controlXic/onYX_Wind_Gesture_Midi_Controller/00_FIRMWARE/README.md

# onYX 
## MCU parts 

**Left, Mouth, Right, Router:** ESP32_WROOM_32D. ArduinoIDE  
**onyx_uChip_048:** PIC32MM0256GPM048-E_PT. MPLAB X IDE  
**Transducer_OLD:** Arduino Micro / Atmega32u4. ArduinoIDE
