controlXic/onYX_Wind_Gesture_Midi_Controller/docs/IMG-20261105-WA0009.jpg

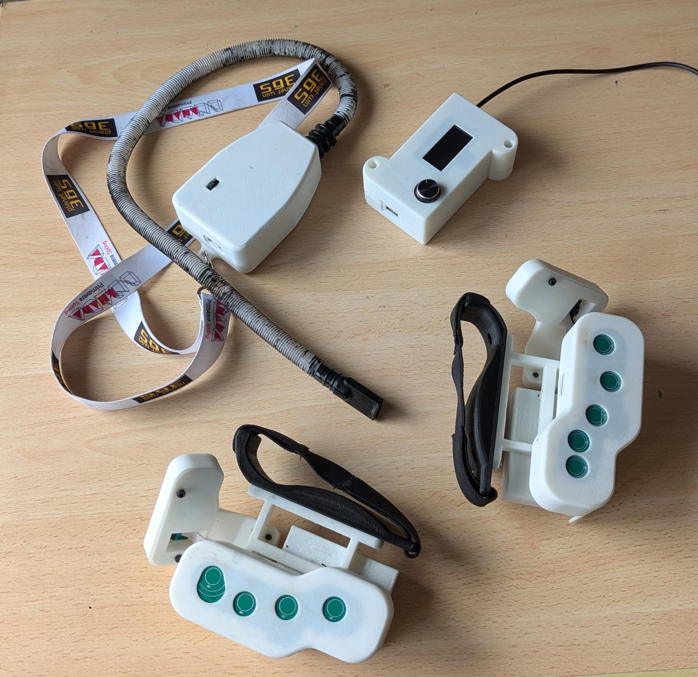
docs/IMG-20261105-WA0009.jpg
