controlXic/onYX_Wind_Gesture_Midi_Controller/Images/IMG-20210422-WA0029.jpg

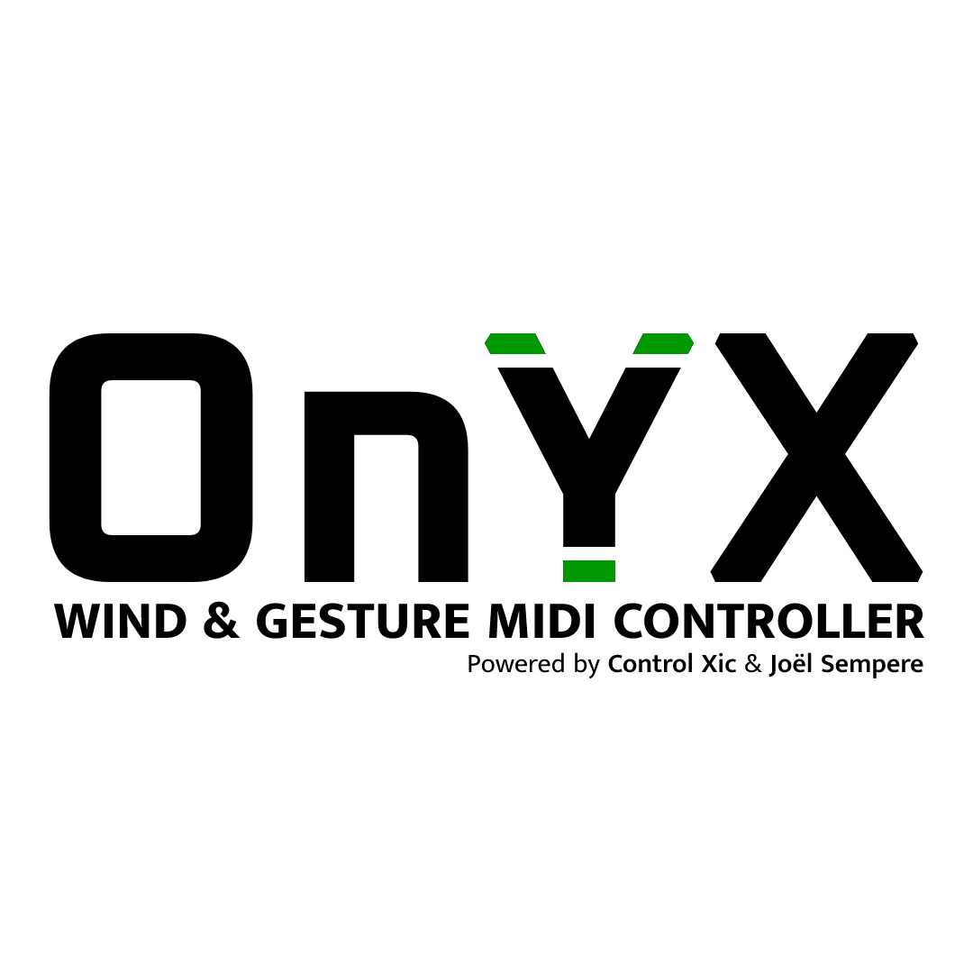
Images/IMG-20210422-WA0029.jpg
