controlXic/onYX_Wind_Gesture_Midi_Controller/01_PCB/onyxMandosV3_Dreta/onyxMandosV3_Dreta.step

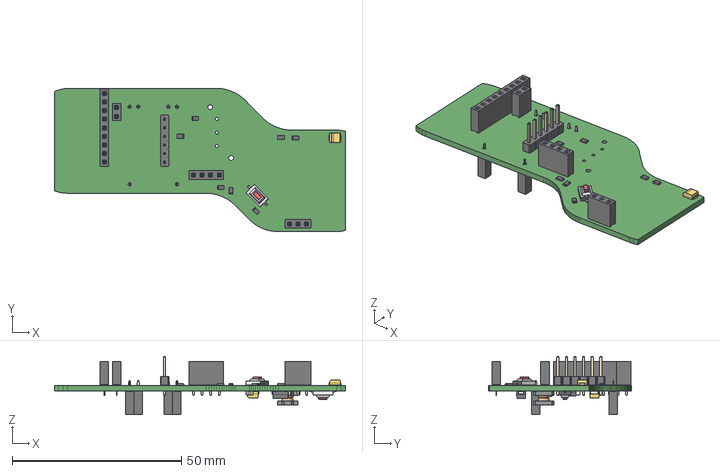
[picture p8: CAD file, 2026-11-02]
01_PCB/onyxMandosV3_Dreta/onyxMandosV3_Dreta.step
86.0 x 42.3 x 17.2 mm
