controlXic/onYX_Wind_Gesture_Midi_Controller/02_CAD/01_STL/boca/baseCase.stl

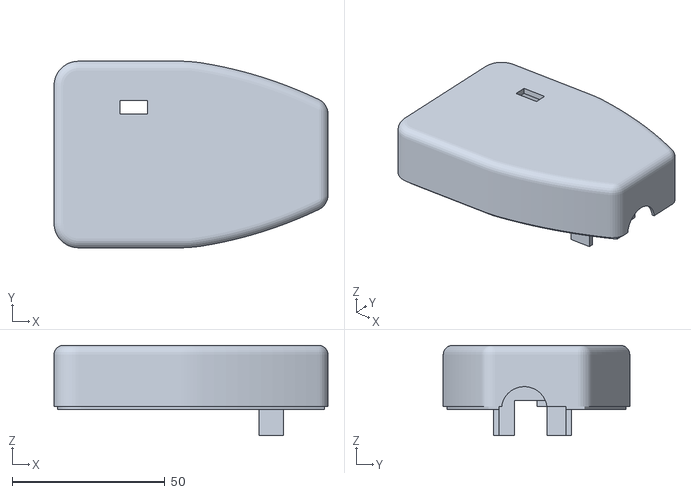
[picture p9: CAD file, 2026-11-02]
02_CAD/01_STL/boca/baseCase.stl
89.6 x 61.0 x 29.5
