controlXic/onYX_Wind_Gesture_Midi_Controller/02_CAD/01_STL/Dreta/basePolze.stl

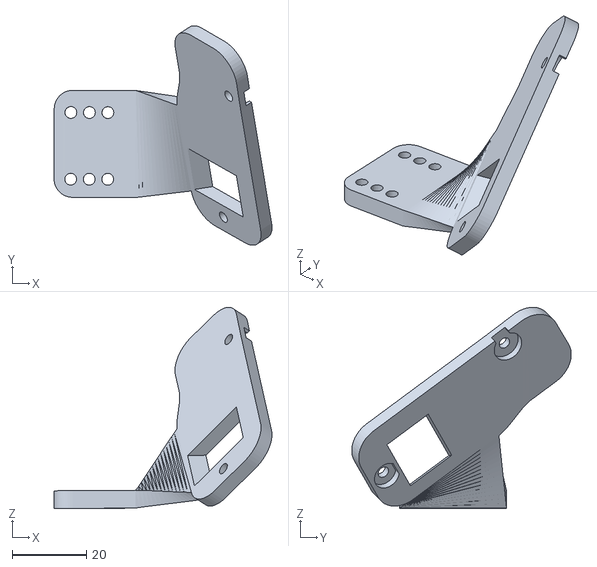
[picture p10: CAD file, 2026-11-02]
02_CAD/01_STL/Dreta/basePolze.stl
58.9 x 59.3 x 54.4
