controlXic/onYX_Wind_Gesture_Midi_Controller/02_CAD/01_STL/Esquerra/tapaPolze.stl

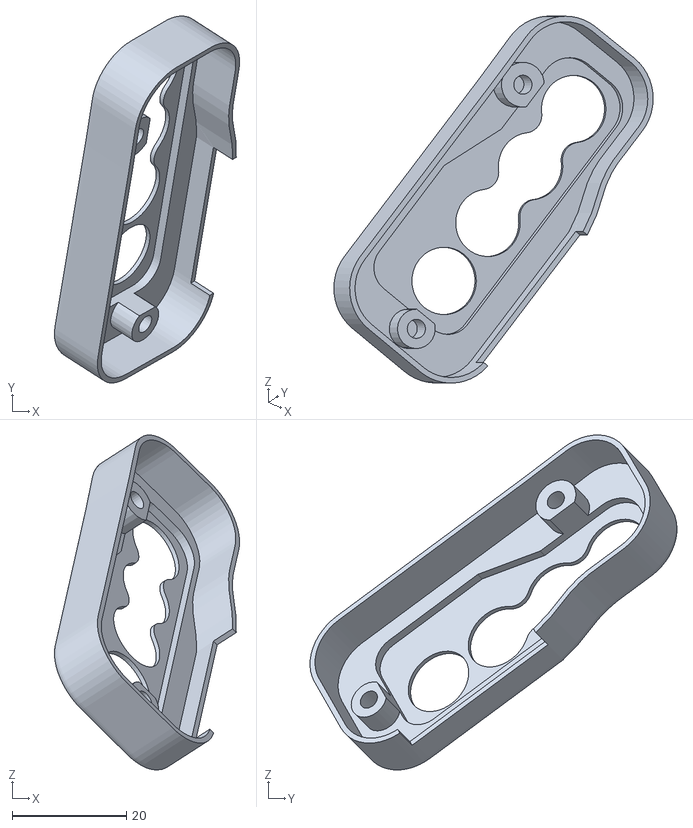
[picture p11: CAD file, 2026-11-02]
02_CAD/01_STL/Esquerra/tapaPolze.stl
32.4 x 64.2 x 58.6
