controlXic/onYX_Wind_Gesture_Midi_Controller/02_CAD/01_STL/router/baseRouter.stl

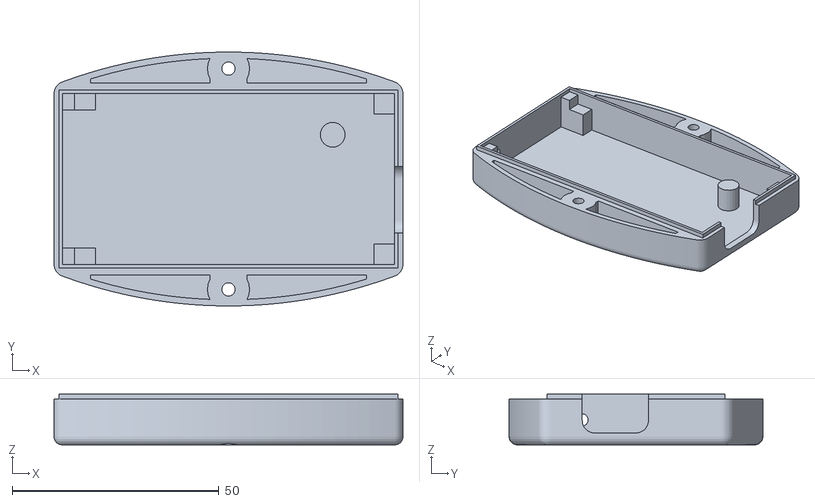
[picture p12: CAD file, 2026-11-02]
02_CAD/01_STL/router/baseRouter.stl
84.4 x 61.4 x 12.3
