controlXic/onYX_Wind_Gesture_Midi_Controller/02_CAD/01_STL/boca/tapaCase.stl

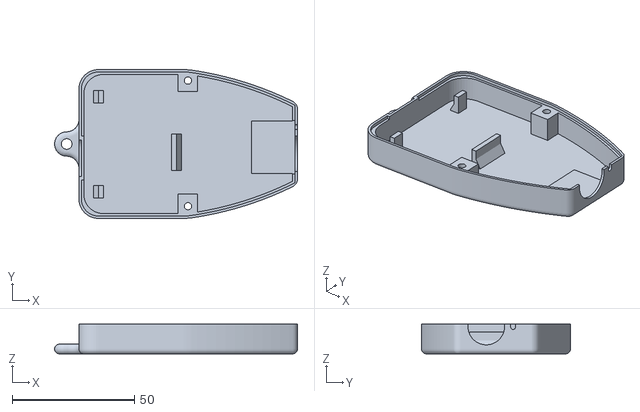
[picture p13: CAD file, 2026-11-02]
02_CAD/01_STL/boca/tapaCase.stl
99.6 x 61.0 x 12.2
