controlXic/onYX_Wind_Gesture_Midi_Controller/02_CAD/01_STL/Dreta/suportTouchPolze.stl

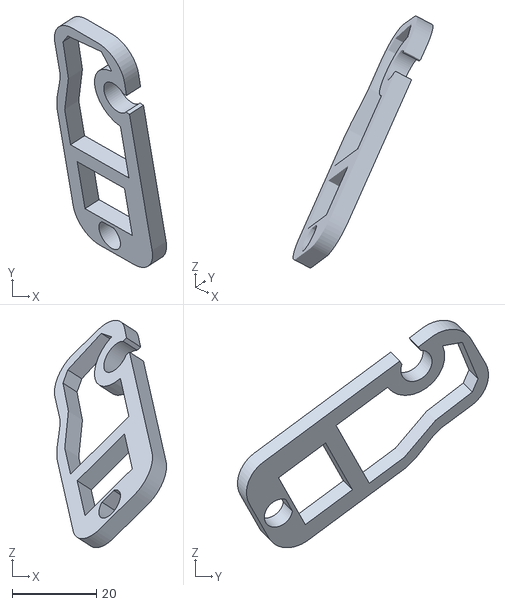
[picture p14: CAD file, 2026-11-02]
02_CAD/01_STL/Dreta/suportTouchPolze.stl
26.6 x 59.5 x 53.9
