controlXic/onYX_Wind_Gesture_Midi_Controller/02_CAD/01_STL/Esquerra/pom.stl

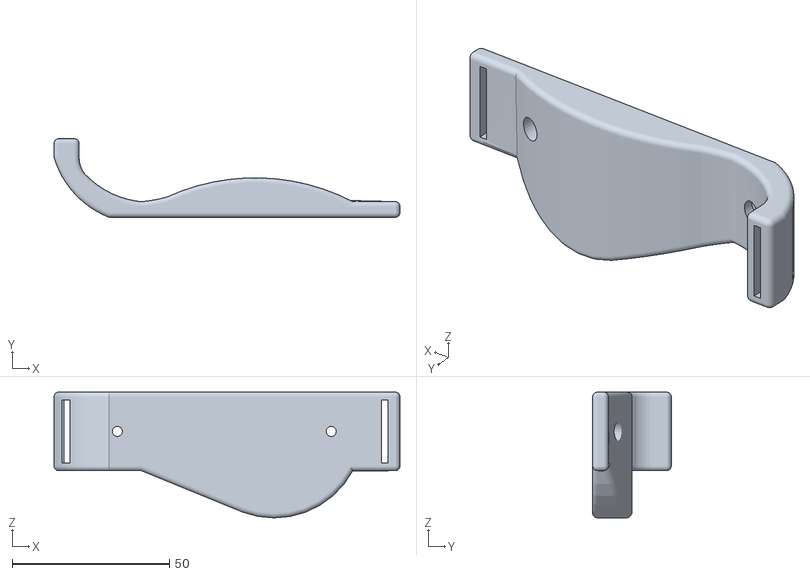
[picture p15: CAD file, 2026-11-02]
02_CAD/01_STL/Esquerra/pom.stl
110.0 x 25.0 x 40.0
