controlXic/onYX_Wind_Gesture_Midi_Controller/02_CAD/01_STL/router/tapaRouter.stl

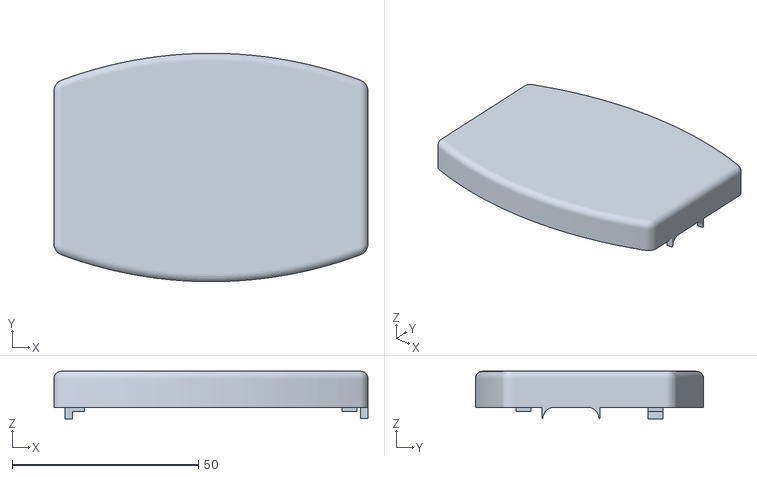
[picture p16: CAD file, 2026-11-02]
02_CAD/01_STL/router/tapaRouter.stl
84.4 x 61.4 x 12.8
