controlXic/onYX_Wind_Gesture_Midi_Controller/02_CAD/01_STL/boca/baseBatt.stl

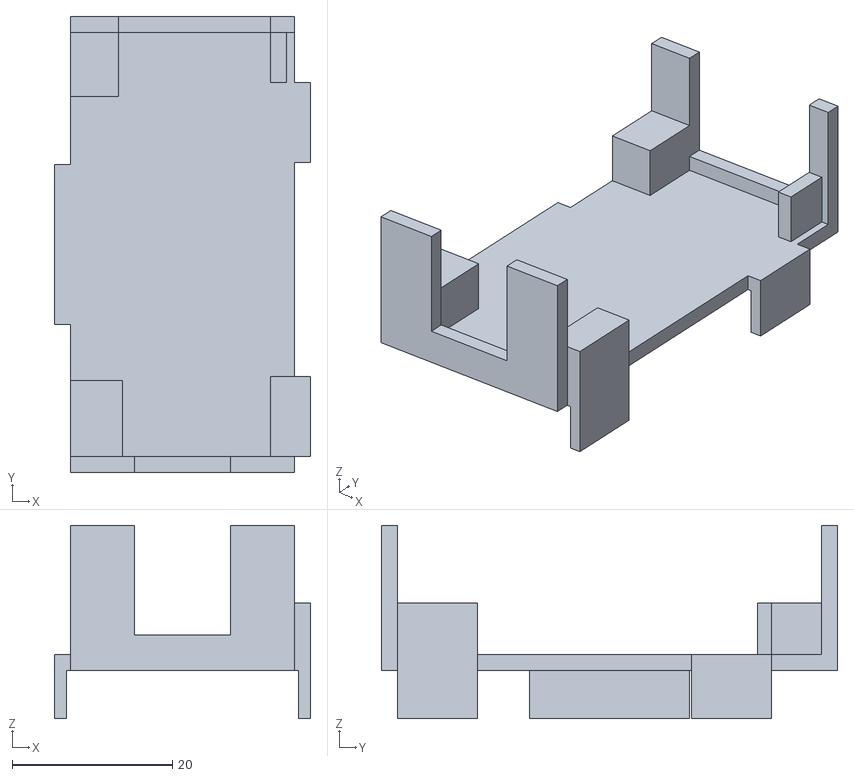
[picture p17: CAD file, 2026-11-02]
02_CAD/01_STL/boca/baseBatt.stl
32.0 x 57.0 x 24.2
