controlXic/onYX_Wind_Gesture_Midi_Controller/02_CAD/01_STL/Dreta/suportPcb.stl

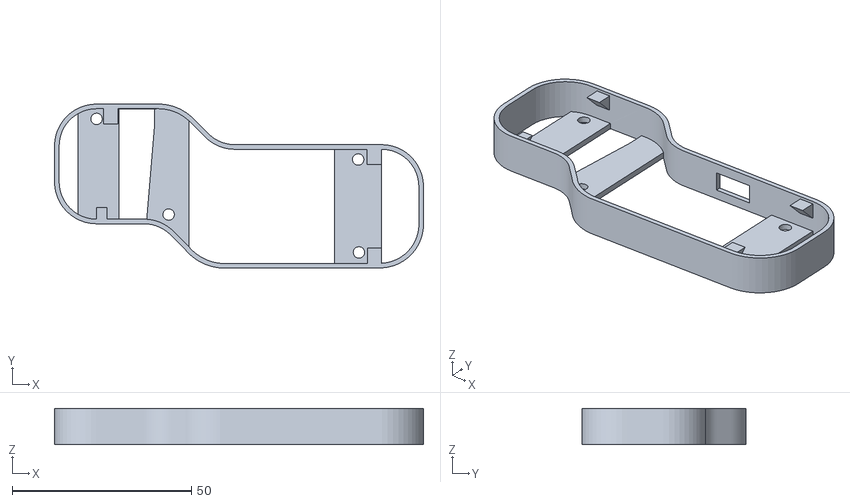
[picture p18: CAD file, 2026-11-02]
02_CAD/01_STL/Dreta/suportPcb.stl
102.9 x 45.7 x 10.1
