controlXic/onYX_Wind_Gesture_Midi_Controller/02_CAD/01_STL/Esquerra/tapaDits.stl

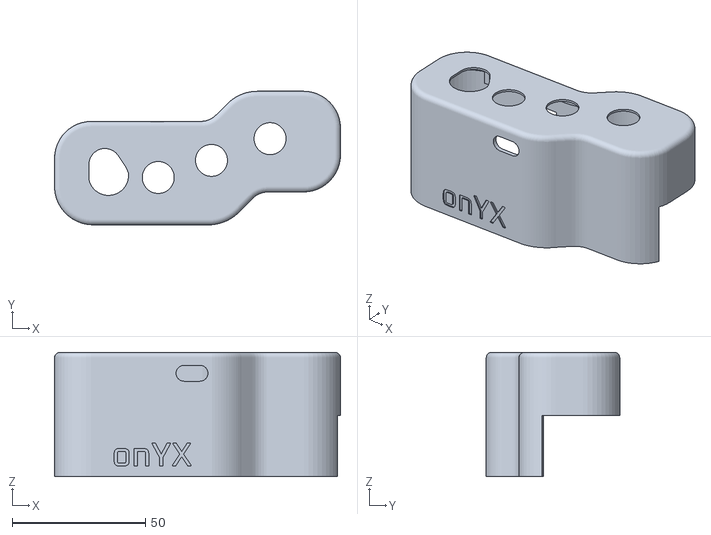
[picture p19: CAD file, 2026-11-02]
02_CAD/01_STL/Esquerra/tapaDits.stl
107.3 x 50.1 x 46.6
