controlXic/onYX_Wind_Gesture_Midi_Controller/02_CAD/01_STL/boca/T-vent.stl

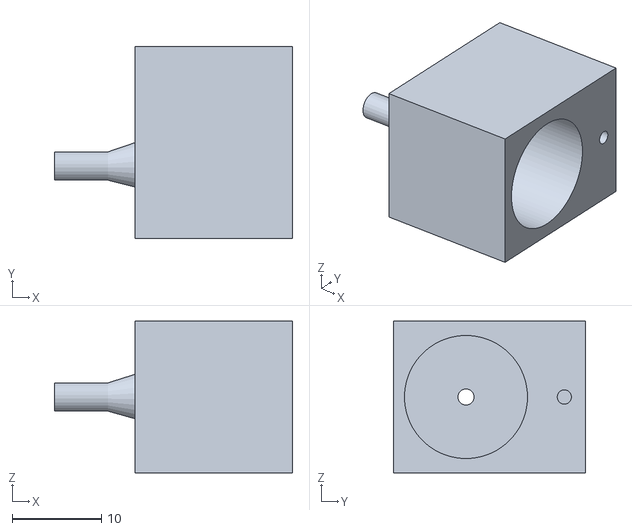
[picture p20: CAD file, 2026-11-02]
02_CAD/01_STL/boca/T-vent.stl
26.6 x 21.5 x 17.0
