controlXic/onYX_Wind_Gesture_Midi_Controller/02_CAD/01_STL/Dreta/baseUnio.stl

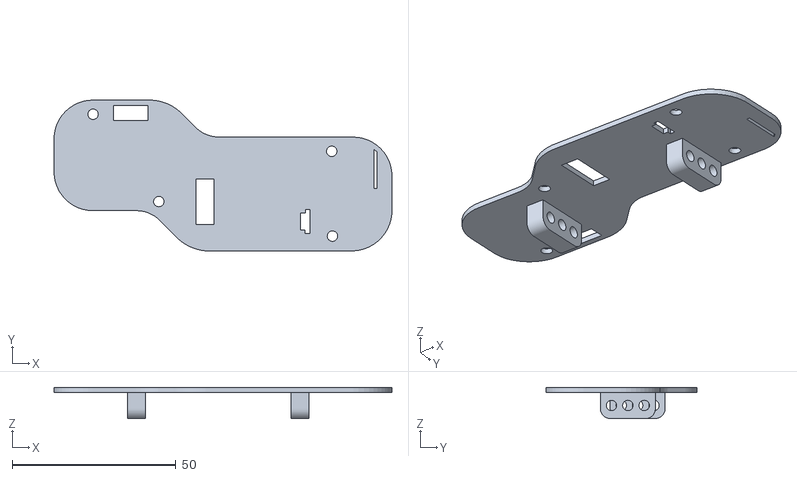
[picture p21: CAD file, 2026-11-02]
02_CAD/01_STL/Dreta/baseUnio.stl
103.3 x 46.1 x 9.50
