controlXic/onYX_Wind_Gesture_Midi_Controller/02_CAD/01_STL/Dreta/tapaBateria.stl

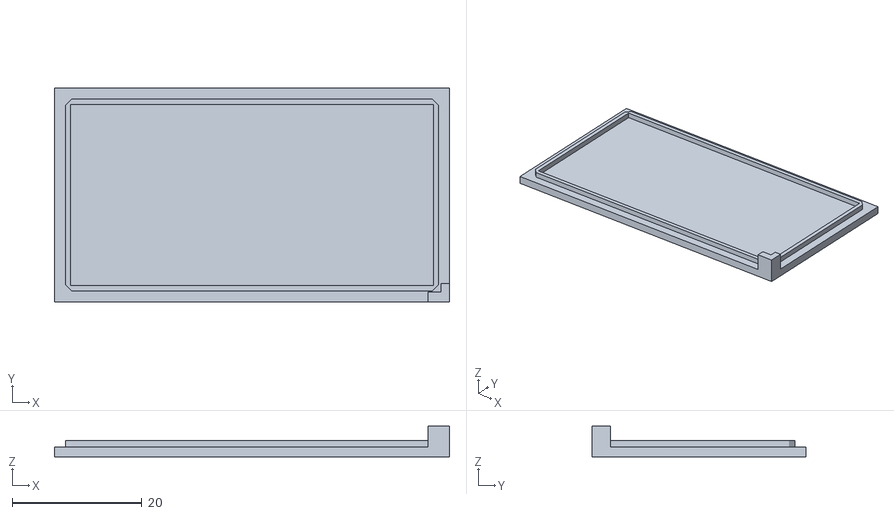
[picture p22: CAD file, 2026-11-02]
02_CAD/01_STL/Dreta/tapaBateria.stl
61.0 x 33.0 x 4.74
