controlXic/onYX_Wind_Gesture_Midi_Controller/02_CAD/01_STL/Dreta/unioPomDitsPolze.stl

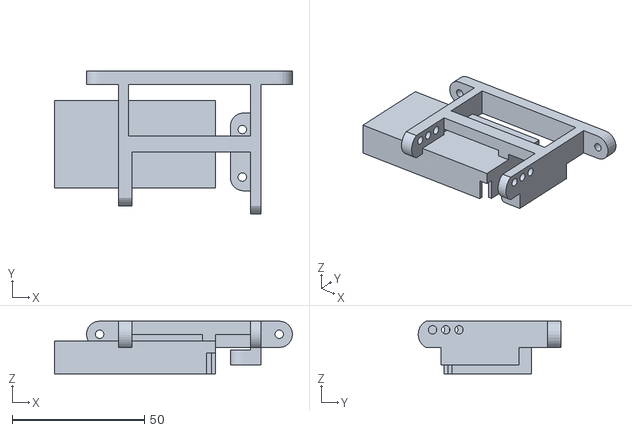
[picture p23: CAD file, 2026-11-02]
02_CAD/01_STL/Dreta/unioPomDitsPolze.stl
90.1 x 54.0 x 20.0
