controlXic/onYX_Wind_Gesture_Midi_Controller/02_CAD/01_STL/Esquerra/suportPcb2.stl

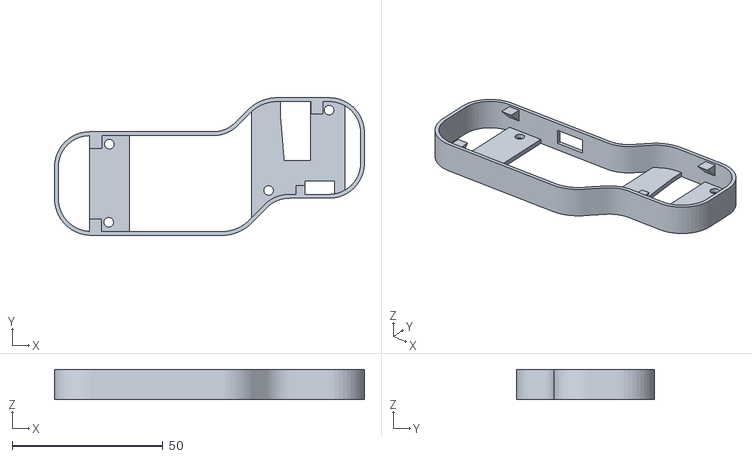
[picture p24: CAD file, 2026-11-02]
02_CAD/01_STL/Esquerra/suportPcb2.stl
102.9 x 45.7 x 10.1
