controlXic/onYX_Wind_Gesture_Midi_Controller/02_CAD/01_STL/Dreta/suportTouchDits.stl

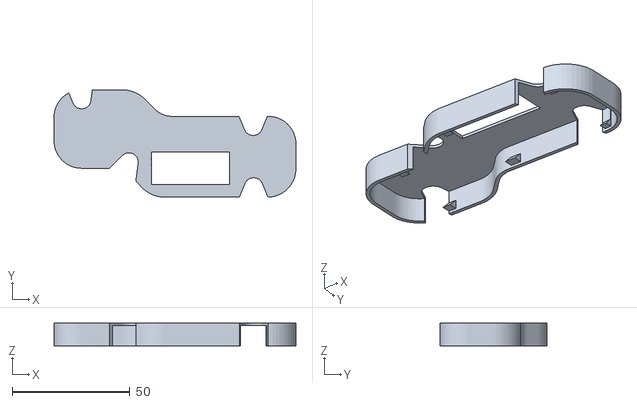
[picture p25: CAD file, 2026-11-02]
02_CAD/01_STL/Dreta/suportTouchDits.stl
102.9 x 45.7 x 9.61
