controlXic/onYX_Wind_Gesture_Midi_Controller/(list of files, cad)

Other CAD files:
02_CAD/01_STL/Esquerra/baseUnio.stl
02_CAD/01_STL/Esquerra/basePolze.stl
02_CAD/01_STL/Esquerra/tapaBateria.stl
02_CAD/01_STL/Dreta/tapaPolze.stl
02_CAD/01_STL/Esquerra/unioPomDitsPolze.stl
02_CAD/01_STL/Dreta/tapaDits.stl
02_CAD/01_STL/Esquerra/gruixMigPolze.stl
02_CAD/01_STL/Dreta/pom.stl
02_CAD/00_WORK/CASE_v4.skp
