controlXic/onYX_Wind_Gesture_Midi_Controller/01_PCB/onyxMandosTouchV3_Dreta/onyxMandosTouchV3_Dreta.kicad_pcb

## KiCad design 01_PCB/onyxMandosTouchV3_Dreta/onyxMandosTouchV3_Dreta.kicad_pcb (2026-11-02)

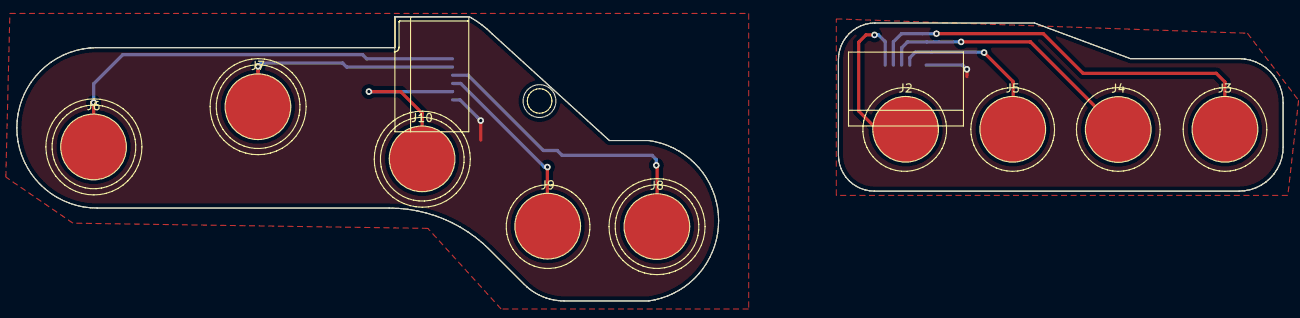
[picture p27: board onyxMandosTouchV3_Dreta.kicad_pcb from above]

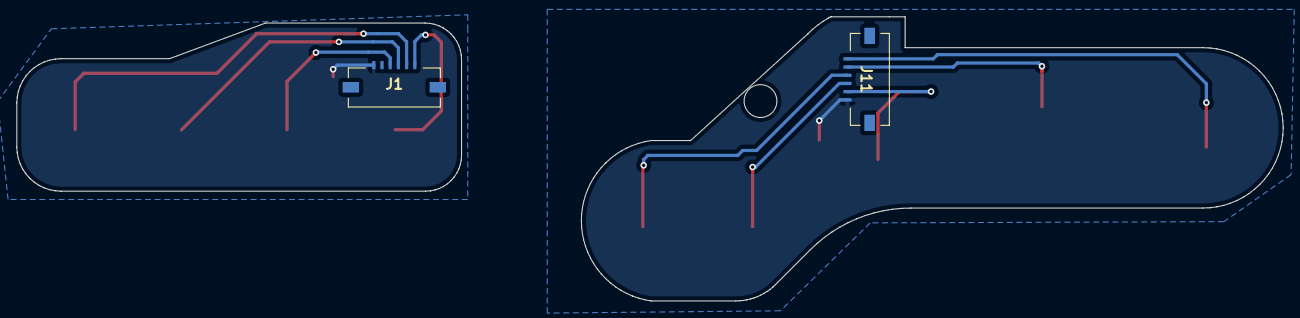
[picture p28: board onyxMandosTouchV3_Dreta.kicad_pcb from below]

Board: 2 copper layers, 154.3 x 34.6 mm, 11 parts (2 on the bottom side), 9 nets.

Parts:
J1, J11: 200529-0060; 2005290060
J2, J3, J4, J5, J6, J7, J8, J9, J10: Conn_01x01_Male; onYX_touch

Connections:
/K0_R: J1.6, J2.1
/K1_R: J1.5, J3.1
/K2_R: J1.4, J4.1
/K3_R: J1.3, J5.1
/K4_R: J6.1, J11.6
/K5_R: J7.1, J11.5
/K6_R: J8.1, J11.4
/K7_R: J9.1, J11.3
/K8_R: J10.1, J11.2
