controlXic/onYX_Wind_Gesture_Midi_Controller/01_PCB/onyxMandosV3_Dreta/onyxMandosV3_Dreta.kicad_pcb

## KiCad design 01_PCB/onyxMandosV3_Dreta/onyxMandosV3_Dreta.kicad_pcb (2026-11-02)

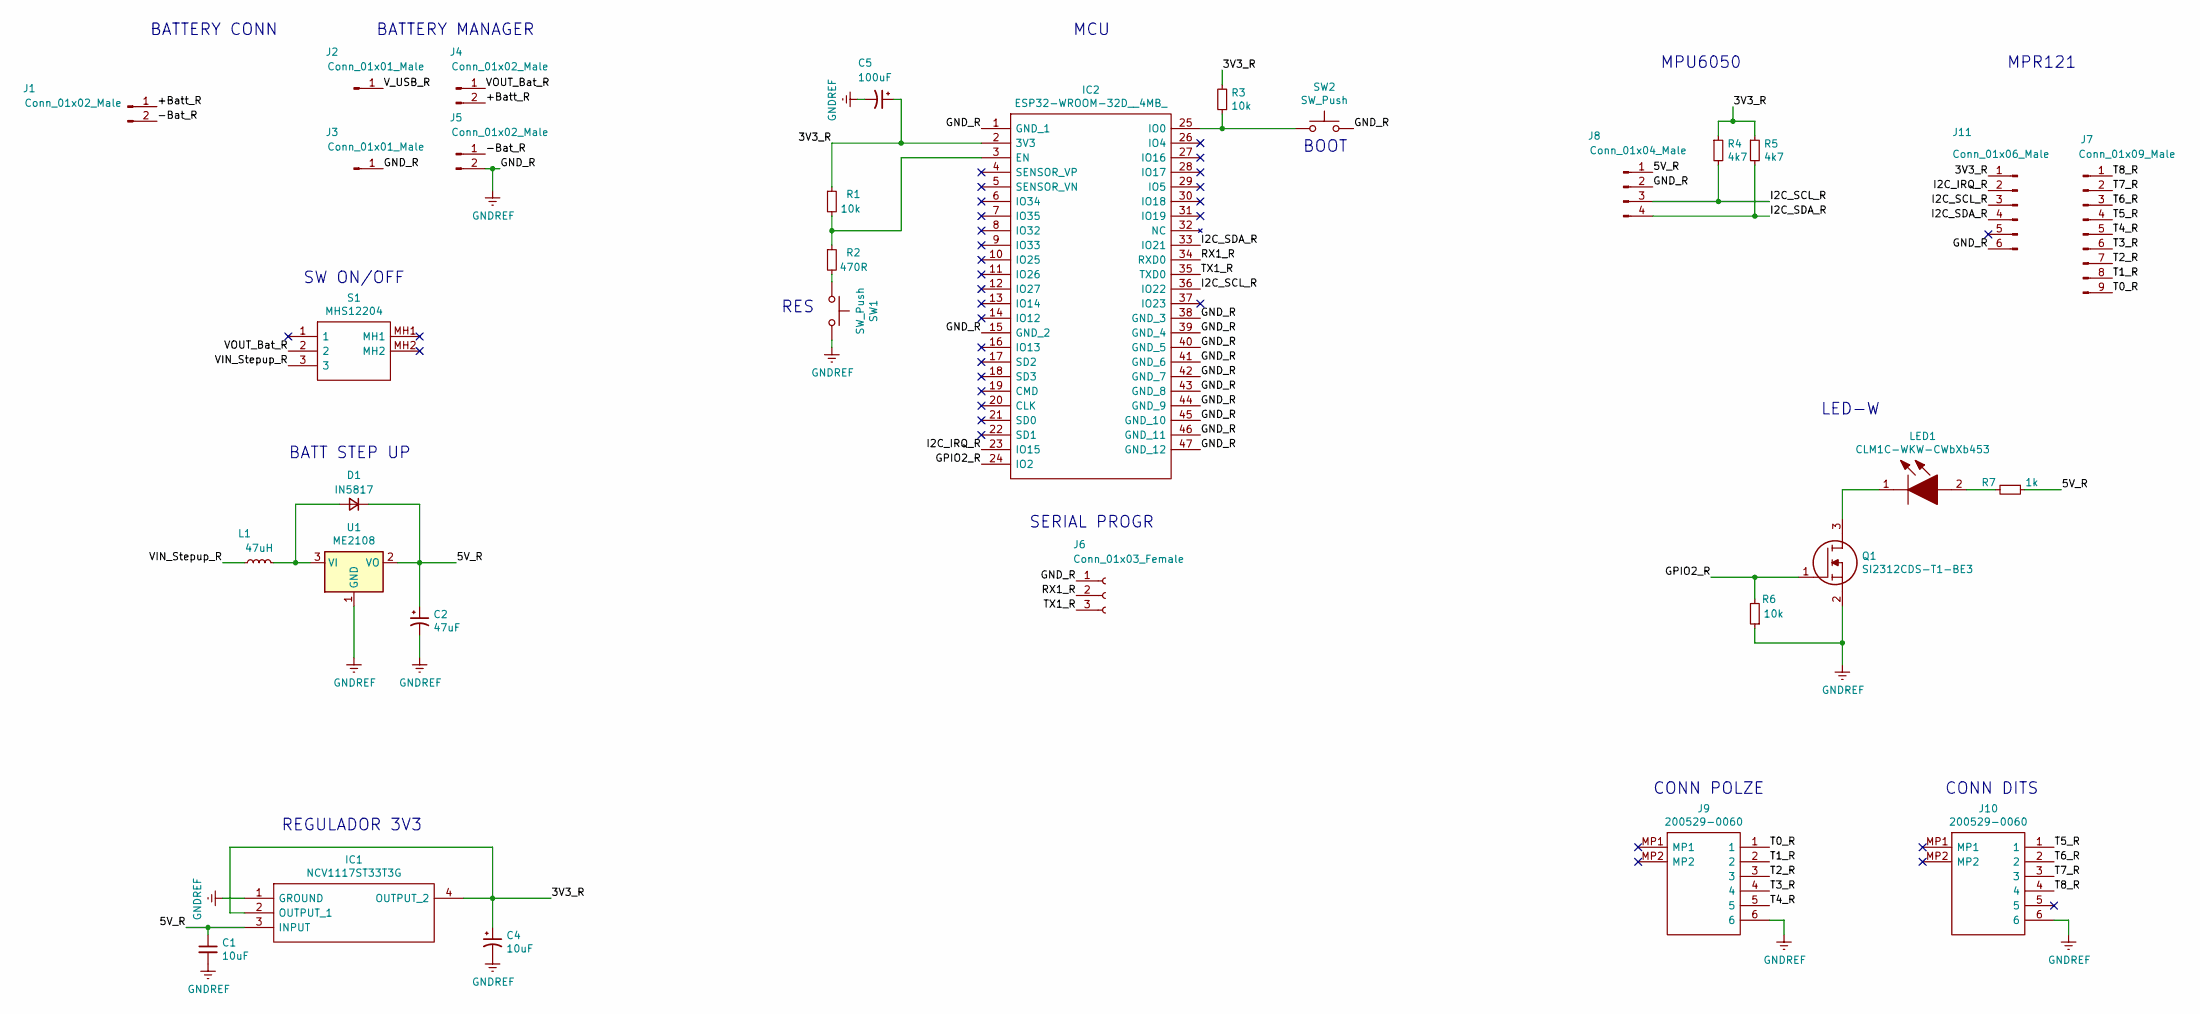
[picture p29: schematic onyxMandosV3_Dreta.kicad_sch]

Parts:
C1: 10uF; C_0805_2012Metric_Pad1.15x1.40mm_HandSolder
C2: 47uF; CP_EIA-3528-21_Kemet-B_Pad1.50x2.35mm_HandSolder
C4: 10uF; CP_EIA-3528-21_Kemet-B_Pad1.50x2.35mm_HandSolder
C5: 100uF; CP_EIA-3528-15_AVX-H
D1: IN5817; D_SMA
IC1: NCV1117ST33T3G; SOT230P700X180-4N; Manufacturer_Part_Number NCV1117ST33T3G; Mouser Part Number 863-NCV1117ST33T3G
IC2: ESP32-WROOM-32D__4MB_; ESP32WROOM32D4MB; Manufacturer_Part_Number ESP32-WROOM-32D (4MB); Mouser Part Number 356-ESP32WROOM-32D
J1, J4, J5: Conn_01x02_Male; PinSocket_1x02_P2.54mm_Vertical
J2, J3: Conn_01x01_Male; PinSocket_1x01_P2.54mm_Vertical
J6: Conn_01x03_Female; PinSocket_1x03_P2.54mm_Vertical
J7: Conn_01x09_Male; PinSocket_1x09_P2.54mm_Vertical
J8: Conn_01x04_Male; PinSocket_1x04_P2.54mm_Vertical
J9, J10: 200529-0060; 2005290060; Manufacturer_Part_Number 200529-0060; Mouser Part Number 538-200529-0060
J11: Conn_01x06_Male; PinHeader_1x06_P2.54mm_Vertical
L1: 47uH; L_Bourns_SRN6045TA
LED1: CLM1C-WKW-CWbXb453; LEDM3528X205N; Manufacturer_Part_Number CLM1C-WKW-CWbXb453; Mouser Part Number 941-CLM1CWKWCWBXB453
Q1: SI2312CDS-T1-BE3; SOT95P237X112-3N; Manufacturer_Part_Number SI2312CDS-T1-BE3; Mouser Part Number 78-SI2312CDS-T1-BE3
R1, R3, R6: 10k; R_0805_2012Metric_Pad1.15x1.40mm_HandSolder
R2: 470R; R_0805_2012Metric_Pad1.15x1.40mm_HandSolder
R4, R5: 4k7; R_0805_2012Metric_Pad1.15x1.40mm_HandSolder
R7: 1k; R_0805_2012Metric_Pad1.15x1.40mm_HandSolder
S1: MHS12204; Manufacturer_Part_Number MHS12204; Mouser Part Number 506-MHS12204
SW1, SW2: SW_Push; SW_SPST_CK_RS282G05A3
U1: ME2108; SOT-89-3

Connections:
/3V3_R: C4.1, C5.1, IC1.2 (OUTPUT_1), IC1.4 (OUTPUT_2), IC2.2 (3V3), J11.1, R1.1, R3.2, R4.1, R5.1
/5V_R: C1.1, C2.1, D1.1 (K), IC1.3 (INPUT), J8.1, R7.1, U1.2 (VO)
/+Batt_R: J1.1, J4.2
/-Bat_R: J1.2, J5.1
/GPIO2_R: IC2.24 (IO2), Q1.1, R6.2
/I2C_IRQ_R: IC2.23 (IO15), J11.2
/I2C_SCL_R: IC2.36 (IO22), J8.3, J11.3, R4.2
/I2C_SDA_R: IC2.33 (IO21), J8.4, J11.4, R5.2
/RX1_R: IC2.34 (RXD0), J6.2
/T0_R: J7.9, J9.1
/T1_R: J7.8, J9.2
/T2_R: J7.7, J9.3
/T3_R: J7.6, J9.4
/T4_R: J7.5, J9.5
/T5_R: J7.4, J10.1
/T6_R: J7.3, J10.2
/T7_R: J7.2, J10.3
/T8_R: J7.1, J10.4
/TX1_R: IC2.35 (TXD0), J6.3
/VIN_Stepup_R: L1.1, S1.3
/VOUT_Bat_R: J4.1, S1.2
/V_USB_R: J2.1
GNDREF: C1.2, C2.2, C4.2, C5.2, IC1.1 (GROUND), IC2.1 (GND_1), IC2.15 (GND_2), IC2.38 (GND_3), IC2.39 (GND_4), IC2.40 (GND_5), IC2.41 (GND_6), IC2.42 (GND_7), IC2.43 (GND_8), IC2.44 (GND_9), IC2.45 (GND_10), IC2.46 (GND_11), IC2.47 (GND_12), J3.1, J5.2, J6.1, J8.2, J9.6, J10.6, J11.6, Q1.2, R6.1, SW1.2, SW2.2, U1.1 (GND)
unnamed: D1.2 (A), L1.2, U1.3 (VI)
unnamed: IC2.3 (EN), R1.2, R2.1
unnamed: IC2.25 (IO0), R3.1, SW2.1
unnamed: LED1.1, Q1.3
unnamed: LED1.2, R7.2
unnamed: R2.2, SW1.1

Notes on the sheet:
MPR121
BATTERY MANAGER
MPU6050
CONN POLZE
BATT STEP UP
MCU
BOOT
LED-W
BATTERY CONN
RES
CONN DITS
SW ON/OFF
REGULADOR 3V3
SERIAL PROGR

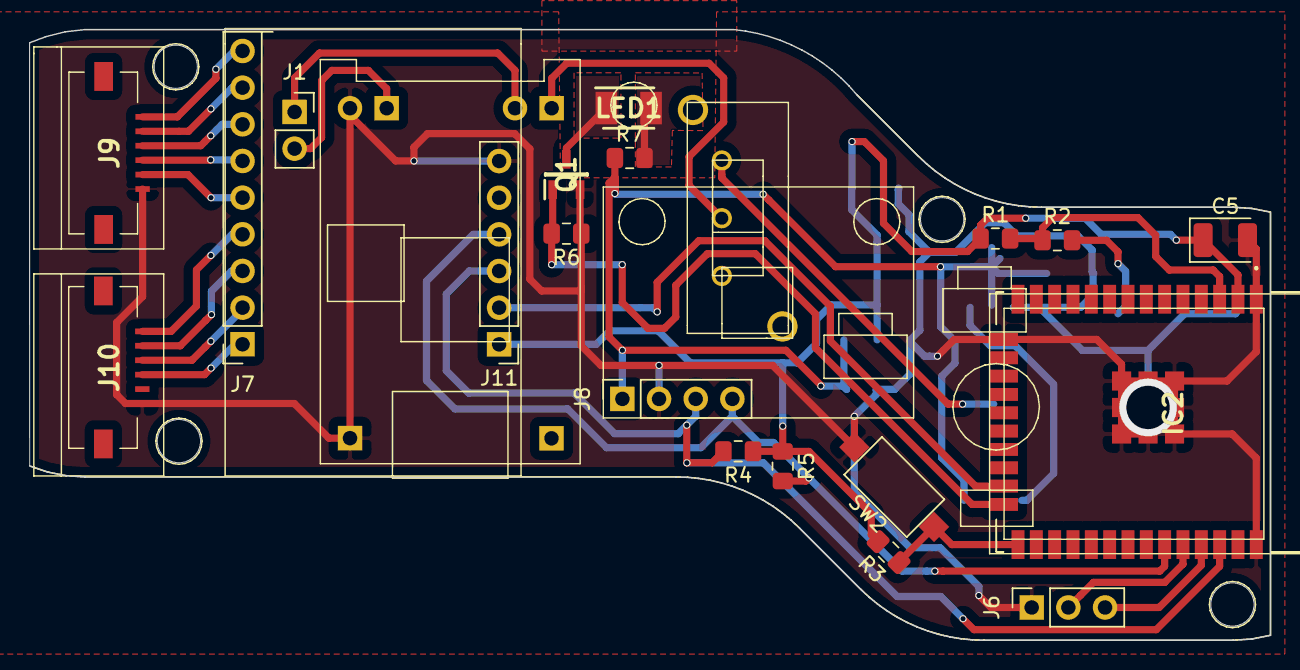
[picture p30: board onyxMandosV3_Dreta.kicad_pcb from above]

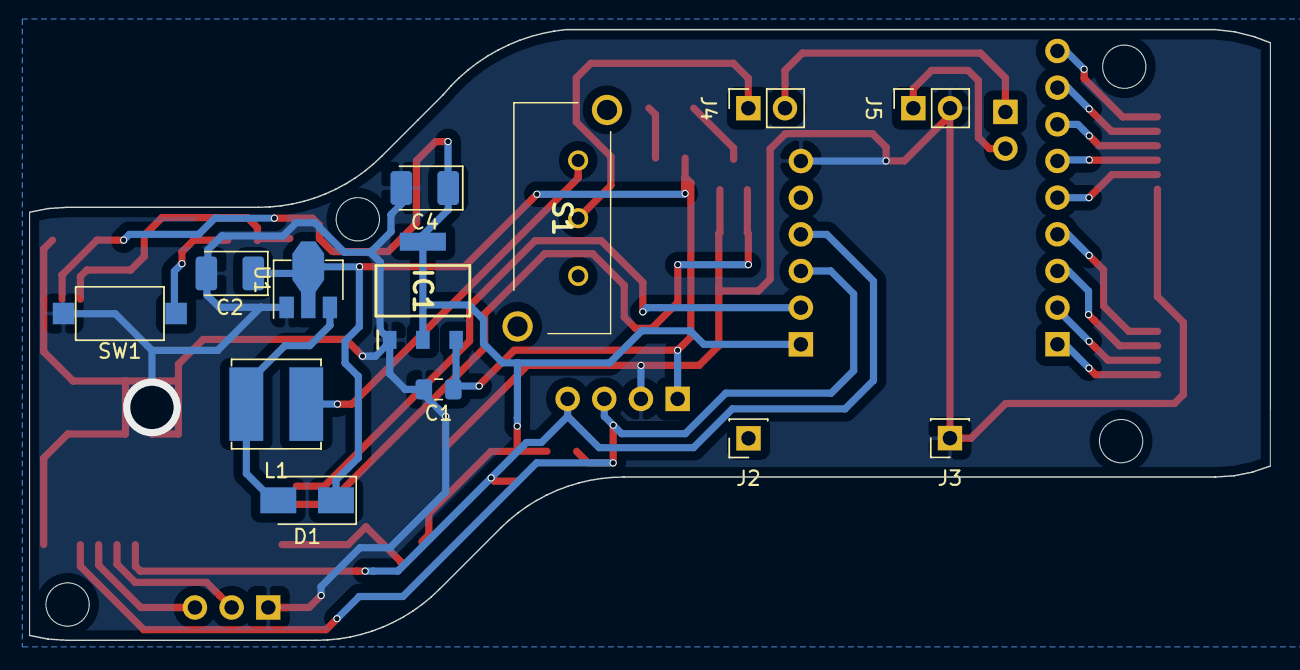
[picture p31: board onyxMandosV3_Dreta.kicad_pcb from below]

Board: 2 copper layers, 86.0 x 42.3 mm, 32 parts (13 on the bottom side), 28 nets.
