controlXic/onYX_Wind_Gesture_Midi_Controller/01_PCB/onyxTransducerPCB/onyxTransducerPCB.kicad_pcb

## KiCad design 01_PCB/onyxTransducerPCB/onyxTransducerPCB.kicad_pcb (2026-11-02)

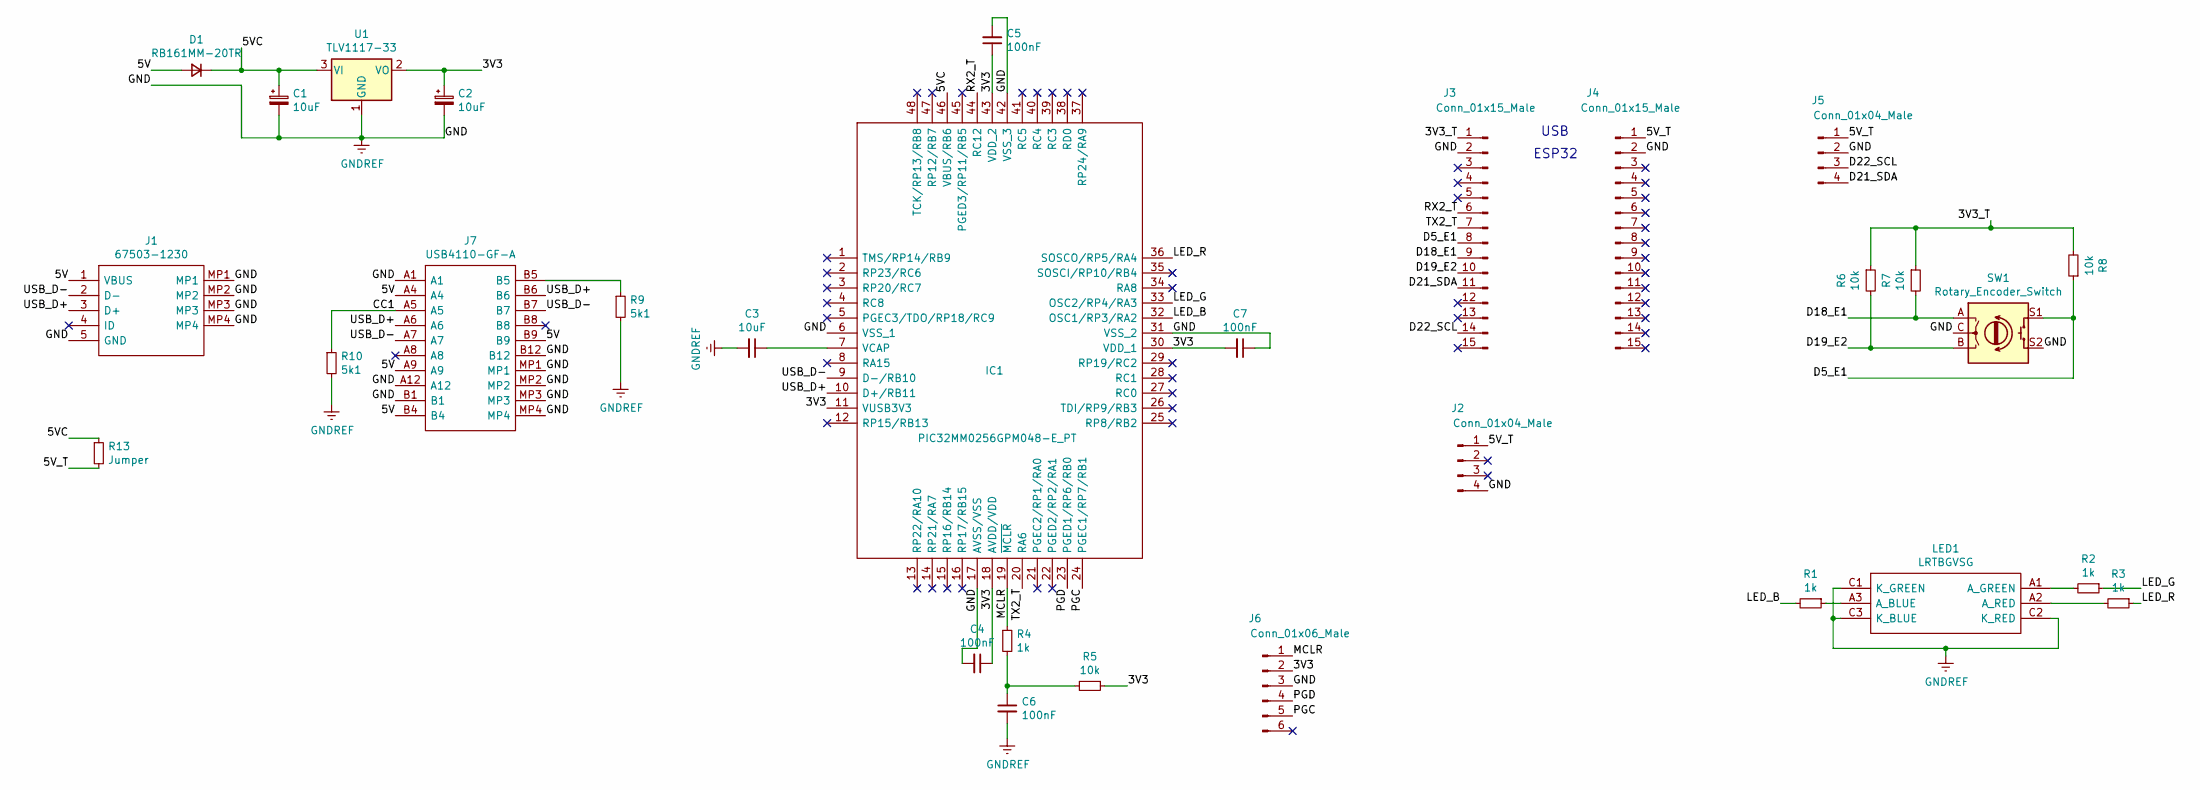
[picture p32: schematic onyxTransducerPCB.kicad_sch]

Parts:
C1, C2: 10uF; CP_EIA-3216-18_Kemet-A
C3: 10uF; C_0805_2012Metric_Pad1.15x1.40mm_HandSolder
C4, C5, C6, C7: 100nF; C_0805_2012Metric_Pad1.15x1.40mm_HandSolder
D1: RB161MM-20TR; D_SOD-123F
IC1: PIC32MM0256GPM048-E_PT; QFP50P900X900X120-48N; Manufacturer_Part_Number PIC32MM0256GPM048-E/PT; Mouser Part Number 579-MM0256GPM048E/PT
J1: 67503-1230; 675031230; Manufacturer_Part_Number 67503-1230; Mouser Part Number 538-67503-1230
J2, J5: Conn_01x04_Male; PinHeader_1x04_P2.54mm_Vertical
J3, J4: Conn_01x15_Male; PinHeader_1x15_P2.54mm_Vertical
J6: Conn_01x06_Male; PinSocket_1x06_P2.54mm_Vertical
J7: USB4110-GF-A; USB4110GFA; Manufacturer_Part_Number USB4110-GF-A; Mouser Part Number 640-USB4110-GF-A
LED1: LRTBGVSG; Manufacturer_Part_Number LRTBGVSG
R1, R2, R3, R4: 1k; R_0805_2012Metric_Pad1.15x1.40mm_HandSolder
R5, R6, R7, R8: 10k; R_0805_2012Metric_Pad1.15x1.40mm_HandSolder
R9, R10: 5k1; R_0805_2012Metric_Pad1.15x1.40mm_HandSolder
R13: Jumper; R_0805_2012Metric_Pad1.15x1.40mm_HandSolder
SW1: Rotary_Encoder_Switch; RotaryEncoder_Alps_EC11E-Switch_Vertical_H20mm
U1: TLV1117-33; SOT-223-3_TabPin2

Connections:
/3V3: C2.1, C4.1, C5.1, C7.2, IC1.11 (VUSB3V3), IC1.18 (AVDD/VDD), IC1.30 (VDD_1), IC1.43 (VDD_2), J6.2, R5.1, U1.2 (VO)
/3V3_T: J3.1, R6.1, R7.1, R8.2
/5V: D1.2 (A), J1.1 (VBUS), J7.A4, J7.A9, J7.B4, J7.B9; also elsewhere on the board
/5VC: C1.1, D1.1 (K), IC1.46 (VBUS/RB6), R13.1, U1.3 (VI)
/5V_T: J2.1, J4.1, J5.1, R13.2
/CC1: J7.A5, R10.1
/D5_E1: J3.8, R8.1, SW1.S1
/D18_E1: J3.9, R7.2, SW1.A
/D19_E2: J3.10, R6.2, SW1.B
/D21_SDA: J3.11, J5.4
/D22_SCL: J3.14, J5.3
/LED_B: IC1.32 (OSC1/RP3/RA2), R1.2
/LED_G: IC1.33 (OSC2/RP4/RA3), R2.1
/LED_R: IC1.36 (SOSCO/RP5/RA4), R3.1
/MCLR: IC1.19 (~MCLR), J6.1, R4.1
/PGC: IC1.24 (PGEC1/RP7/RB1), J6.5
/PGD: IC1.23 (PGED1/RP6/RB0), J6.4
/RX2_T: IC1.44 (RC12), J3.6
/TX2_T: IC1.20 (RA6), J3.7
/USB_D+: IC1.10 (D+/RB11), J1.3 (D+), J7.A6, J7.B6
/USB_D-: IC1.9 (D-/RB10), J1.2 (D-), J7.A7, J7.B7
GNDREF: C1.2, C2.2, C3.2, C4.2, C5.2, C6.2, C7.1, IC1.6 (VSS_1), IC1.17 (AVSS/VSS), IC1.31 (VSS_2), IC1.42 (VSS_3), J1.5 (GND), J1.MP1, J1.MP2, J1.MP3, J1.MP4, J2.4, J3.2, J4.2, J5.2, J6.3, J7.A1, J7.A12, J7.B1, J7.B12, J7.MP1, J7.MP2, J7.MP3, J7.MP4, LED1.C1 (K_GREEN), LED1.C2 (K_RED), LED1.C3 (K_BLUE), R9.2, R10.2, SW1.C, SW1.S2, U1.1 (GND); also elsewhere on the board
unnamed: C3.1, IC1.7 (VCAP)
unnamed: C6.1, R4.2, R5.2
unnamed: J7.B5, R9.1
unnamed: LED1.A1 (A_GREEN), R2.2
unnamed: LED1.A2 (A_RED), R3.2
unnamed: LED1.A3 (A_BLUE), R1.1

Notes on the sheet:
ESP32
USB

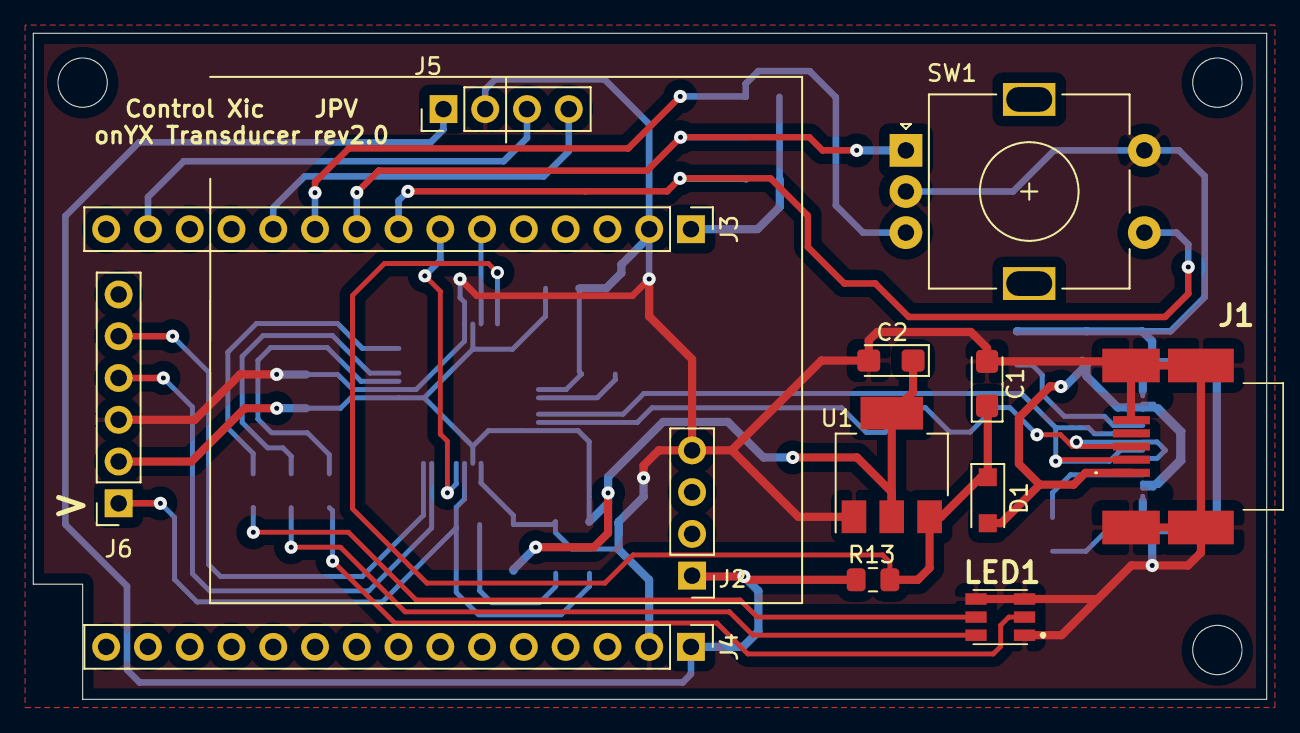
[picture p33: board onyxTransducerPCB.kicad_pcb from above]

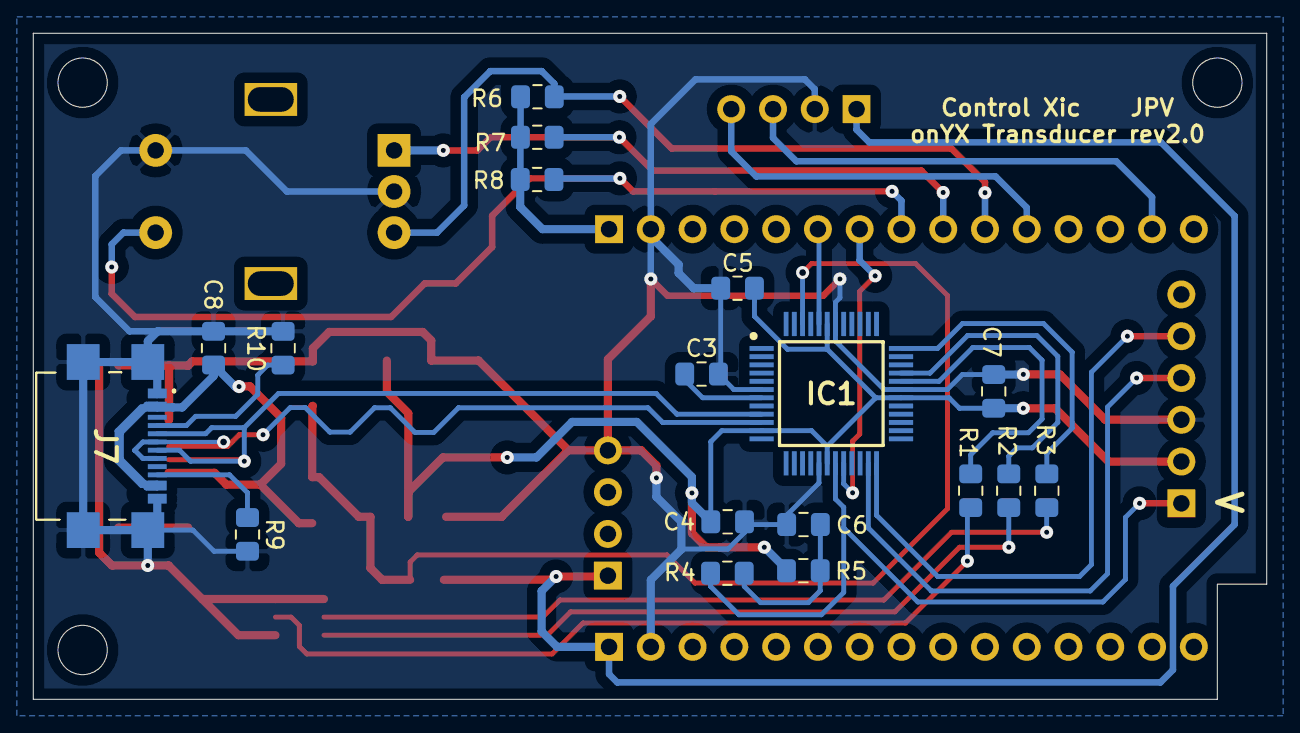
[picture p34: board onyxTransducerPCB.kicad_pcb from below]

Board: 2 copper layers, 75.0 x 40.5 mm, 31 parts (18 on the bottom side), 28 nets.

Other parts of the board:
C8: 100nF; C_0805_2012Metric_Pad1.15x1.40mm_HandSolder

Their connections:
/5V: C8.2; also elsewhere on the board
GNDREF: C8.1; also elsewhere on the board
