controlXic/onYX_Wind_Gesture_Midi_Controller/01_PCB/onyxCtrlVent/onyxCtrlVent.kicad_pcb

## KiCad design 01_PCB/onyxCtrlVent/onyxCtrlVent.kicad_pcb (2026-11-02)

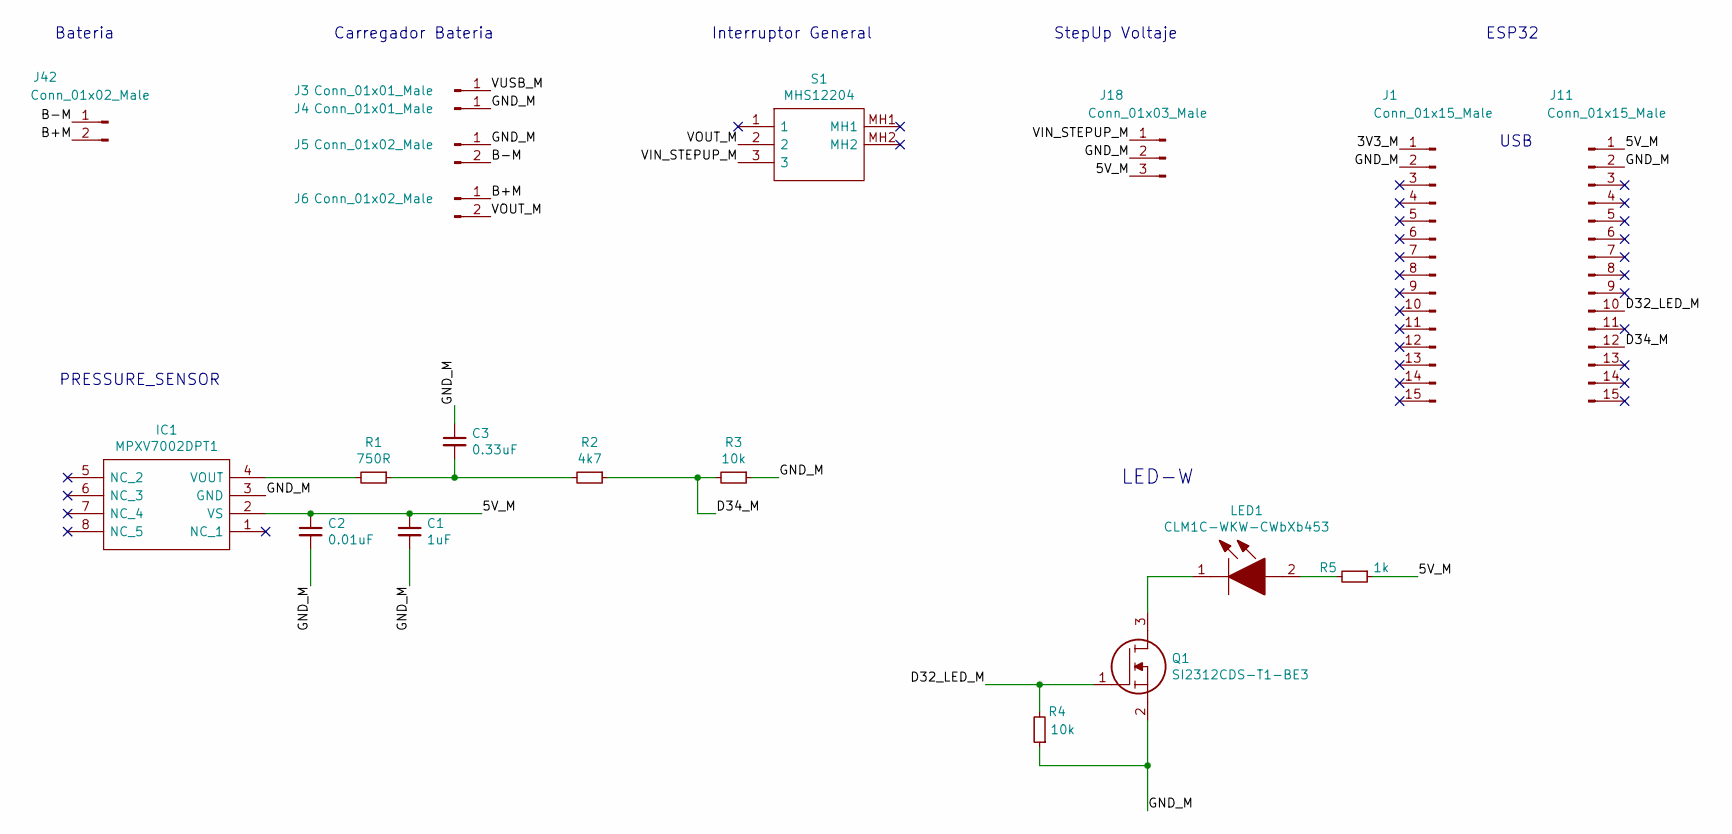
[picture p35: schematic onyxCtrlVent.kicad_sch]

Parts:
C1: 1uF; C_0805_2012Metric_Pad1.15x1.40mm_HandSolder
C2: 0.01uF; C_0805_2012Metric_Pad1.15x1.40mm_HandSolder
C3: 0.33uF; C_0805_2012Metric_Pad1.15x1.40mm_HandSolder
IC1: MPXV7002DPT1; Manufacturer_Part_Number MPXV7002DPT1; Mouser Part Number 841-MPXV7002DPT1
J1, J11: Conn_01x15_Male; PinHeader_1x15_P2.54mm_Vertical
J3, J4: Conn_01x01_Male; PinHeader_1x01_P2.54mm_Vertical
J5, J6, J42: Conn_01x02_Male; PinHeader_1x02_P2.54mm_Vertical
J18: Conn_01x03_Male; PinHeader_1x03_P2.54mm_Vertical
LED1: CLM1C-WKW-CWbXb453; LEDM3528X205N; Manufacturer_Part_Number CLM1C-WKW-CWbXb453; Mouser Part Number 941-CLM1CWKWCWBXB453
Q1: SI2312CDS-T1-BE3; SOT95P237X112-3N; Manufacturer_Part_Number SI2312CDS-T1-BE3; Mouser Part Number 78-SI2312CDS-T1-BE3
R1: 750R; R_0805_2012Metric_Pad1.15x1.40mm_HandSolder
R2: 4k7; R_0805_2012Metric_Pad1.15x1.40mm_HandSolder
R3, R4: 10k; R_0805_2012Metric_Pad1.15x1.40mm_HandSolder
R5: 1k; R_0805_2012Metric_Pad1.15x1.40mm_HandSolder
S1: MHS12204; Manufacturer_Part_Number MHS12204; Mouser Part Number 506-MHS12204

Connections:
/3V3_M: J1.1
/5V_M: C1.1, C2.1, IC1.2 (VS), J11.1, J18.3, R5.1
/B+M: J6.1, J42.2
/B-M: J5.2, J42.1
/D32_LED_M: J11.10, Q1.1, R4.2
/D34_M: J11.12, R2.1, R3.2
/GND_M: C1.2, C2.2, C3.1, IC1.3 (GND), J1.2, J4.1, J5.1, J11.2, J18.2, Q1.2, R3.1, R4.1
/VIN_STEPUP_M: J18.1, S1.3
/VOUT_M: J6.2, S1.2
/VUSB_M: J3.1
unnamed: C3.2, R1.1, R2.2
unnamed: IC1.4 (VOUT), R1.2
unnamed: LED1.1, Q1.3
unnamed: LED1.2, R5.2

Notes on the sheet:
ESP32
Bateria
PRESSURE_SENSOR
Interruptor General
StepUp Voltaje
LED-W
USB
Carregador Bateria

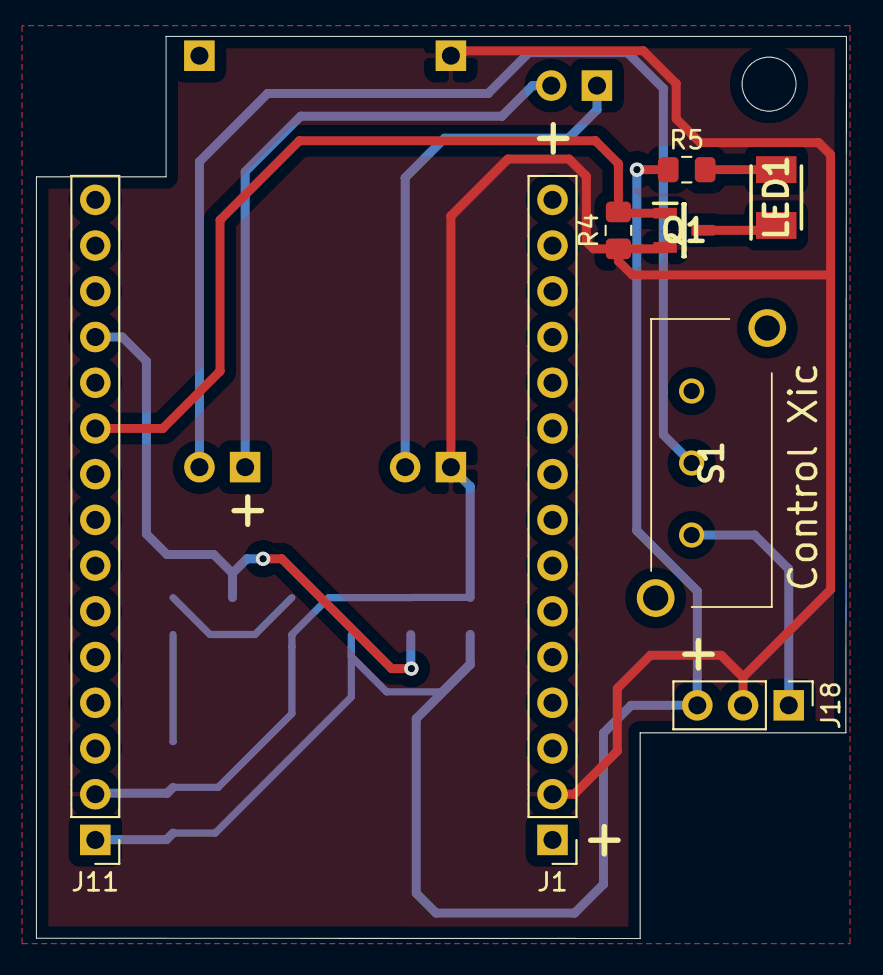
[picture p36: board onyxCtrlVent.kicad_pcb from above]

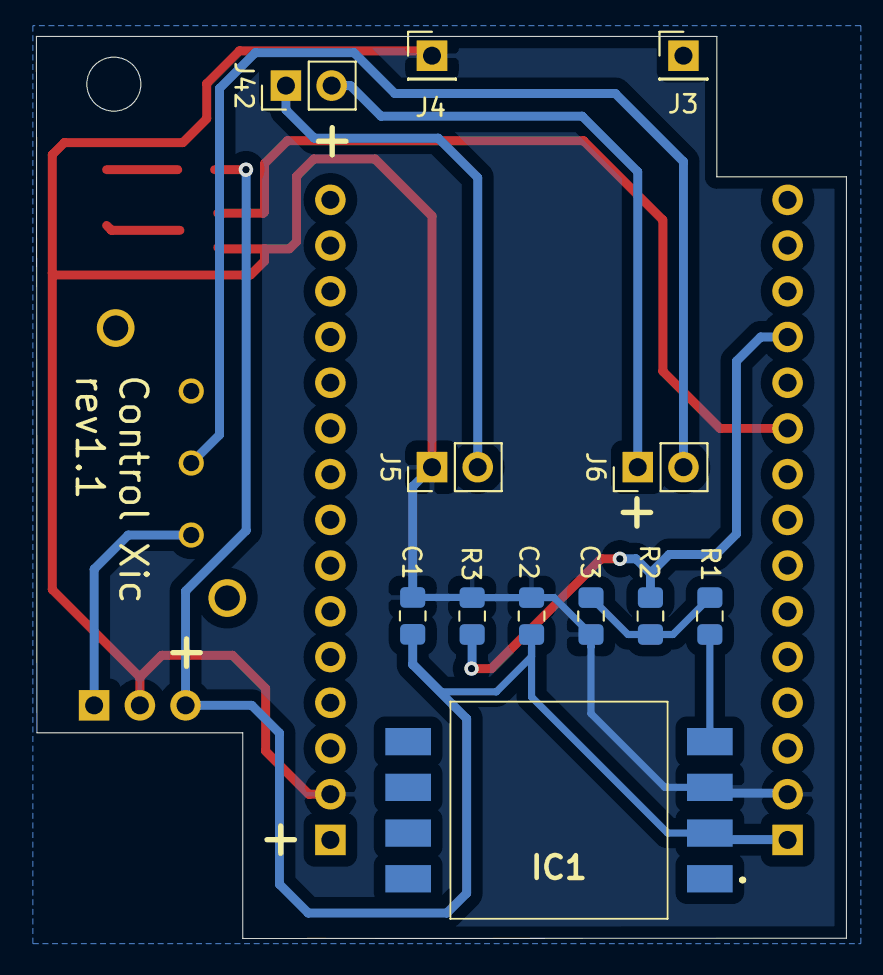
[picture p37: board onyxCtrlVent.kicad_pcb from below]

Board: 2 copper layers, 45.0 x 50.1 mm, 20 parts (12 on the bottom side), 12 nets.
