controlXic/onYX_Wind_Gesture_Midi_Controller/00_FIRMWARE/onyx_uChip_048/onyx_uChip_048.X/byteToSound.c

#include "byteToSound.h"
#include "app_device_audio_midi.h"
#include "stdbool.h"



////////////////////////////////////////////////////////////////////////////////    
// Variables
////////////////////////////////////////////////////////////////////////////////


// // Data polsadors mandos //
extern uint16_t buttonByte;
extern uint8_t vel;
extern uint8_t vel2;
extern uint8_t channel;

// Flags //
extern bool flg1, flg2, flg3, flg4, flg5, flg6, flg7, flg8, flg9, flg10;
extern bool flg11, flg12, flg13, flg14, flg15, flg16, flg17, flg18, flg19, flg20;
extern bool flg21, flg22, flg23, flg24, flg25, flg26, flg27, flg28, flg29, flg30;
extern bool flg31, flg32, flg33, flg34, flg35, flg36, flg37, flg38, flg39, flg40;
extern bool flg41, flg42, flg43, flg44, flg45, flg46, flg47, flg48, flg49, flg50;
extern bool flg51, flg52, flg53, flg54, flg55, flg56, flg57, flg58, flg59, flg60;
extern bool flg61, flg62, flg63, flg64, flg65, flg66, flg67, flg68, flg69, flg70;
extern bool flg71, flg72, flg73, flg74, flg75, flg76, flg77, flg78, flg79, flg80;
extern bool flg81, flg82, flg83, flg84, flg85, flg86, flg87, flg88, flg89, flg90;
extern bool flg91, flg92, flg93, flg94, flg95, flg96, flg97, flg98, flg99, flg100;
extern bool flg101, flg102, flg103, flg104, flg105, flg106, flg107, flg108, flg109, flg110;
extern bool flg111, flg112, flg113, flg114, flg115, flg116, flg117, flg118, flg119, flg120;
extern bool flg121, flg122, flg123, flg124, flg125, flg126, flg127, flg128, flg129, flg130;
extern bool flg131, flg132, flg133, flg134, flg135, flg136, flg137, flg138, flg139, flg140;
extern bool flg141, flg142, flg143, flg144, flg145, flg146, flg147, flg148, flg149, flg150;
extern bool flg151, flg152, flg153, flg154, flg155, flg156, flg157, flg158, flg159, flg160;
extern bool flg161, flg162, flg163, flg164, flg165, flg166, flg167, flg168, flg169, flg170;
extern bool flg171, flg172, flg173, flg174, flg175, flg176, flg177, flg178, flg179, flg180;
extern bool flg181, flg182, flg183, flg184, flg185, flg186, flg187, flg188, flg189, flg190;
extern bool flg191;



void Octave_0_On(void)
{
    // C //
    if(buttonByte == 487 && flg11 == false)
    {
        noteOn(channel, 36, vel2);
        flg11 = true;
    }
    // C# //
    if(buttonByte == 495 && flg12 == false)
    {
        noteOn(channel, 37, vel2);
        flg12 = true;
    }
    // D //
    if(buttonByte == 231 && flg13 == false)
    {
        noteOn(channel, 38, vel2);
        flg13 = true;
    }
    // D# //
    if(buttonByte == 743 && flg14 == false)
    {
        noteOn(channel, 39, vel2);
        flg14 = true;
    }
    // E //
    if(buttonByte == 103 && flg15 == false)
    {
        noteOn(channel, 40, vel2);
        flg15 = true;
    }
    // F //
    if(buttonByte == 39 && flg16 == false)
    {
        noteOn(channel, 41, vel2);
        flg16 = true;
    }
    // F# //
    if((buttonByte == 71|| buttonByte == 135 || buttonByte == 167) && flg17 == false)
    {
        noteOn(channel, 42, vel2);
        flg17 = true;
    }
    // G //
    if(buttonByte == 7 && flg18 == false)
    {
        noteOn(channel, 43, vel2);
        flg18 = true;
    }
    // G# //
    if(buttonByte == 15 && flg19 == false)
    {
        noteOn(channel, 44, vel2);
        flg19 = true;
    }
    // A //
    if(buttonByte == 3 && flg20 == false)
    {
        noteOn(channel, 45, vel2);
        flg20 = true;
    }
    // A# //
    if((buttonByte == 17 || buttonByte == 35 || buttonByte == 33 || buttonByte == 65) && flg21 == false)
    {
        noteOn(channel, 46, vel2);
        flg21 = true;
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
    {
      noteOff(channel, 107, 0);
      flg183 = false;
    }
    // C4-O3 //
    if((buttonByte != 4482 && buttonByte != 4485 && buttonByte != 4501 || vel < 10) && flg186 == true) 
    {
      noteOff(channel, 108, 0);
      flg186 = false;
    }
    // C#4-O3 //
    if((buttonByte != 4480 || vel < 10) && flg189 == true) 
    {
      noteOff(channel, 109, 0);
      flg189 = false;
    }
}
