controlXic/onYX_Wind_Gesture_Midi_Controller/00_FIRMWARE/onyx_uChip_048/onyx_uChip_048.X/system.c

/********************************************************************
 Software License Agreement:

 The software supplied herewith by Microchip Technology Incorporated
 (the "Company") for its PIC(R) Microcontroller is intended and
 supplied to you, the Company's customer, for use solely and
 exclusively on Microchip PIC Microcontroller products. The
 software is owned by the Company and/or its supplier, and is
 protected under applicable copyright laws. All rights are reserved.
 Any use in violation of the foregoing restrictions may subject the
 user to criminal sanctions under applicable laws, as well as to
 civil liability for the breach of the terms and conditions of this
 license.

 THIS SOFTWARE IS PROVIDED IN AN "AS IS" CONDITION. NO WARRANTIES,
 WHETHER EXPRESS, IMPLIED OR STATUTORY, INCLUDING, BUT NOT LIMITED
 TO, IMPLIED WARRANTIES OF MERCHANTABILITY AND FITNESS FOR A
 PARTICULAR PURPOSE APPLY TO THIS SOFTWARE. THE COMPANY SHALL NOT,
 IN ANY CIRCUMSTANCES, BE LIABLE FOR SPECIAL, INCIDENTAL OR
 CONSEQUENTIAL DAMAGES, FOR ANY REASON WHATSOEVER.
 *******************************************************************/



/** CONFIGURATION Bits **********************************************/
// FDEVOPT
#pragma config SOSCHP = OFF             // Secondary Oscillator High Power Enable bit (SOSC oprerates in normal power mode.)
#pragma config ALTI2C = OFF             // Alternate I2C1 Pins Location Enable bit (Primary I2C1 pins are used)
#pragma config FUSBIDIO = OFF           // USBID pin control (USBID pin is controlled by the USB module)
#pragma config FVBUSIO = OFF            // VBUS Pin Control (VBUS pin is controlled by the USB module)
#pragma config USERID = 0xFFFF          // User ID bits (User ID bits)

// FICD
#pragma config JTAGEN = OFF             // JTAG Enable bit (JTAG is disabled)
#pragma config ICS = PGx2               // ICE/ICD Communication Channel Selection bits (Communicate on PGEC2/PGED2)

// FPOR
#pragma config BOREN = BOR3             // Brown-out Reset Enable bits (Brown-out Reset enabled in hardware; SBOREN bit disabled)
#pragma config RETVR = OFF              // Retention Voltage Regulator Enable bit (Retention regulator is disabled)
#pragma config LPBOREN = ON             // Downside Voltage Protection Enable bit (Low power BOR is enabled, when main BOR is disabled)

// FWDT
#pragma config SWDTPS = PS1048576       // Sleep Mode Watchdog Timer Postscale Selection bits (1:1048576)
#pragma config FWDTWINSZ = PS25_0       // Watchdog Timer Window Size bits (Watchdog timer window size is 25%)
#pragma config WINDIS = OFF             // Windowed Watchdog Timer Disable bit (Watchdog timer is in non-window mode)
#pragma config RWDTPS = PS1048576       // Run Mode Watchdog Timer Postscale Selection bits (1:1048576)
#pragma config RCLKSEL = LPRC           // Run Mode Watchdog Timer Clock Source Selection bits (Clock source is LPRC (same as for sleep mode))
#pragma config FWDTEN = OFF             // Watchdog Timer Enable bit (WDT is disabled)

// FOSCSEL
#pragma config FNOSC = FRCDIV           // Oscillator Selection bits (Fast RC oscillator (FRC) with divide-by-N)
#pragma config PLLSRC = FRC             // System PLL Input Clock Selection bit (FRC oscillator is selected as PLL reference input on device reset)
#pragma config SOSCEN = OFF             // Secondary Oscillator Enable bit (Secondary oscillator (SOSC) is enabled)
#pragma config IESO = OFF               // Two Speed Startup Enable bit (Two speed startup is disabled)
#pragma config POSCMOD = OFF            // Primary Oscillator Selection bit (Primary oscillator is disabled)
#pragma config OSCIOFNC = OFF           // System Clock on CLKO Pin Enable bit (OSCO pin operates as a normal I/O)
#pragma config SOSCSEL = OFF            // Secondary Oscillator External Clock Enable bit (Crystal is used (RA4 and RB4 are controlled by SOSC))
#pragma config FCKSM = CSECME           // Clock Switching and Fail-Safe Clock Monitor Enable bits (Clock switching is enabled; Fail-safe clock monitor is enabled)

// FSEC
#pragma config CP = OFF                 // Code Protection Enable bit (Code protection is disabled)


   
    
// #pragma config statements should precede project file includes.
// Use project enums instead of #define for ON and OFF.

#include <xc.h>
#include <sys/attribs.h>

#include "system.h"
#include "code/inc/usb/usb_device.h"
//#include "code/inc/bsp/leds.h"
//#include "code/inc/bsp/buttons.h"
#include "code/inc/uart/uart1.h"
#include "code/inc/timers/tmr1.h"


/*********************************************************************
 * Prototypes
 *********************************************************************/
static void SYSTEM_SetOscToUSBCompatible(void);

/*********************************************************************
 * Functions
 *********************************************************************/

/*********************************************************************
* Function: void SYSTEM_Initialize( SYSTEM_STATE state )
*
* Overview: Initializes the system.
*
* PreCondition: None
*
* Input:  SYSTEM_STATE - the state to initialize the system into
*
* Output: None
*
********************************************************************/
void SYSTEM_Initialize( SYSTEM_STATE state )
{    
    
////////////////////////////////////////////////////////////////////////////////
// Inits
////////////////////////////////////////////////////////////////////////////////
    

    
    switch(state)
    {
        case SYSTEM_STATE_USB_START:

            /****************************************************************************
             * Setting the Output Latch SFR(s)
             ***************************************************************************/
            LATA = 0x0000;
            LATB = 0x0000;
            LATC = 0x0000;
            LATD = 0x0000;

            /****************************************************************************
             * Setting the GPIO Direction SFR(s)
             ***************************************************************************/
//            TRISA = 0xFFF7;
//            TRISB = 0xEFFF;
//            TRISC = 0xEFFF;
//            TRISD = 0x001F;
            
            TRISA = 0x87C3;
            TRISB = 0xEFFF;
            TRISC = 0x03FF;
            TRISD = 0x0001;

            /****************************************************************************
             * Setting the Weak Pull Up and Weak Pull Down SFR(s)
             ***************************************************************************/
            CNPDA = 0x0000;
            CNPDB = 0x0000;
            CNPDC = 0x0000;
            CNPDD = 0x0000;
            CNPUA = 0x0000;
            CNPUB = 0x0000;
            CNPUC = 0x0000;
            CNPUD = 0x0000;

            /****************************************************************************
             * Setting the Open Drain SFR(s)
             ***************************************************************************/
            ODCA = 0x0000;
            ODCB = 0x0000;
            ODCC = 0x0000;
            ODCD = 0x0000;

            /****************************************************************************
             * Setting the Analog/Digital Configuration SFR(s)
             ***************************************************************************/
//            ANSELA = 0x380F;
//            ANSELB = 0xE01C;
//            ANSELC = 0x0123;
            
            ANSELA = 0x0003;
            ANSELB = 0xE01C;
            ANSELC = 0x0123;

            SYSTEM_SetOscToUSBCompatible();   
			 
            UART1_Initialize();
            TMR1_Initialize();
            
            
            //LED_Enable(LED_USB_DEVICE_STATE);
            //BUTTON_Enable(BUTTON_DEVICE_AUDIO_MIDI);
            break;
            
        case SYSTEM_STATE_USB_SUSPEND:
            //If developing a bus powered USB device that needs to be USB compliant,
            //insert code here to reduce the I/O pin and microcontroller power consumption,
            //so that the total current is <2.5mA from the USB host's VBUS supply.
            //If developing a self powered application (or a bus powered device where
            //official USB compliance isn't critical), nothing strictly needs
            //to be done during USB suspend.

            //USBSleepOnSuspend();
            break;

        case SYSTEM_STATE_USB_RESUME:
            //Here would be a good place to restore I/O pins and application states
            //back to their original values that may have been saved/changed at the 
            //start of the suspend event (ex: when the SYSTEM_Initialize(SYSTEM_STATE_USB_SUSPEND)
            //callback was called.
            
            //If you didn't change any I/O pin states prior to entry into suspend,
            //then nothing explicitly needs to be done here.  However, by the time
            //the firmware returns from this function, the full application should
            //be restored into effectively exactly the same state as the application
            //was in, prior to entering USB suspend.
            
            //Additionally, before returning from this function, make sure the microcontroller's
            //currently active clock settings are compatible with USB operation, including
            //taking into consideration all possible microcontroller features/effects
            //that can affect the oscillator settings (such as internal/external 
            //switchover (two speed start up), fail-safe clock monitor, PLL lock time,
            //external crystal/resonator startup time (if using a crystal/resonator),
            //etc.

            //Additionally, the official USB specifications dictate that USB devices
            //must become fully operational and ready for new host requests/normal 
            //USB communication after a 10ms "resume recovery interval" has elapsed.
            //In order to meet this timing requirement and avoid possible issues,
            //make sure that all necessary oscillator startup is complete and this
            //function has returned within less than this 10ms interval.

            break;

        default:
            break;
    }
    
}


/*********************************************************************
* Function: static void SYSTEM_SetOscToUSBCompatible(void)
*
* Overview: Configures the PIC32MM0256GPM064 PIM on the Explorer 16/32 to run 
*     in PRI+SPLL at 24MHz CPU, 48MHz USB module clock frequencies, both 
*     derived from the 8MHz crystal on the demo board.
*
* PreCondition: None
*
* Input:  None
*
* Output: None
*
********************************************************************/
static void SYSTEM_SetOscToUSBCompatible(void)
{
    volatile uint32_t i;
    
    //Unlock sequence for SPLLCON and OSCCON registers.
    SYSKEY = 0;// force lock
    SYSKEY = 0xAA996655;  // unlock sequence
    SYSKEY = 0x556699AA;  // lock sequence
    
    //Temporarily switch to 8MHz FRC (without PLL), so we can safely change the PLL settings,
    //in case we had previously been already running from the PLL.
    OSCCON = OSCCON & 0xF8FFF87E;    //FRC configured for 8MHz output, and set NOSC to run from FRC with divider but without PLL.
    if(OSCCONbits.COSC != OSCCONbits.NOSC)
    {
        //Initiate clock switching operation.
        OSCCONbits.OSWEN = 1;
        while(OSCCONbits.OSWEN == 1);    //Wait for switching complete.
    }
    
    //Configure the PLL to run from the FRC, and output 24MHz for the CPU + Peripheral Bus (and 48MHz for the USB module)
    SPLLCON = 0x02050080;     //PLLODIV = /4, PLLMULT = 12x, PLL source = FRC, so: 8MHz FRC * 12x / 4 = 24MHz CPU and peripheral bus frequency.
    
    //Now switch to the PLL source.
    OSCCON = OSCCON | 0x00000101;    //NOSC = SPLL, initiate clock switch (OSWEN = 1)
    
    
    //Wait for PLL startup/lock and clock switching operation to complete.
    for(i = 0; i < 100000; i++)
    {
        if((CLKSTATbits.SPLLRDY == 1) && (OSCCONbits.OSWEN == 0))
            break;
    }    
    
    //Enable USB active clock tuning for the FRC
    OSCTUN = 0x00009000;    //active clock tuning enabled, source = USB
    
    SYSKEY = 0;             //Re-lock oscillator registers  
}




#if defined(USB_INTERRUPT)
void __ISR(_USB_VECTOR) _USB1Interrupt()
{
    USBDeviceTasks();
}
#endif
