controlXic/onYX_Wind_Gesture_Midi_Controller/00_FIRMWARE/onyx_uChip_048/onyx_uChip_048.X/code/src/uart/uart1.c

/**
  UART1 Generated Driver File

  @Company
    Microchip Technology Inc.

  @File Name
    uart1.c

  @Summary
    This is the generated driver implementation file for the UART1 driver using Foundation Services Library

  @Description
    This header file provides implementations for driver APIs for UART1.
    Generation Information :
        Product Revision  :  Foundation Services Library - pic24-dspic-pic32mm : v1.26
        Device            :  PIC32MM0256GPM064
    The generated drivers are tested against the following:
        Compiler          :  XC32 1.42
        MPLAB             :  MPLAB X 3.45
*/

/*
    (c) 2016 Microchip Technology Inc. and its subsidiaries. You may use this
    software and any derivatives exclusively with Microchip products.

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
    IN NO EVENT WILL MICROCHIP BE LIABLE FOR ANY INDIRECT, SPECIAL, PUNITIVE,
    INCIDENTAL OR CONSEQUENTIAL LOSS, DAMAGE, COST OR EXPENSE OF ANY KIND
    WHATSOEVER RELATED TO THE SOFTWARE, HOWEVER CAUSED, EVEN IF MICROCHIP HAS
    BEEN ADVISED OF THE POSSIBILITY OR THE DAMAGES ARE FORESEEABLE. TO THE
    FULLEST EXTENT ALLOWED BY LAW, MICROCHIP'S TOTAL LIABILITY ON ALL CLAIMS IN
    ANY WAY RELATED TO THIS SOFTWARE WILL NOT EXCEED THE AMOUNT OF FEES, IF ANY,
    THAT YOU HAVE PAID DIRECTLY TO MICROCHIP FOR THIS SOFTWARE.

    MICROCHIP PROVIDES THIS SOFTWARE CONDITIONALLY UPON YOUR ACCEPTANCE OF THESE
    TERMS.
*/

/**
  Section: Included Files
*/
#include <xc.h>
#include "../../inc/uart/uart1.h"

/**
  Section: UART1 APIs
*/

void UART1_Initialize(void)
{
    // Set the UART1 module to the options selected in the user interface.

    // STSEL 1; PDSEL 8N; RTSMD disabled; OVFDIS disabled; ACTIVE disabled; RXINV disabled; WAKE disabled; BRGH enabled; IREN disabled; ON enabled; SLPEN disabled; SIDL disabled; ABAUD disabled; LPBACK disabled; UEN TX_RX; CLKSEL PBCLK; 
    U1MODE = (0x8008 & ~(1<<15)); // disabling UART ON bit  
    // UTXISEL TX_ONE_CHAR; UTXINV disabled; ADDR 0; MASK 0; URXEN disabled; OERR disabled; URXISEL RX_ONE_CHAR; UTXBRK disabled; UTXEN disabled; ADDEN disabled; 
    U1STA = 0x0;
    // BaudRate = 115200; Frequency = 24000000 Hz; BRG 51; 
    U1BRG = 0x33;
     
    //Make sure to set LAT bit corresponding to TxPin as high before UART initialization
    U1STASET = _U1STA_UTXEN_MASK;
    U1MODESET = _U1MODE_ON_MASK;  // enabling UART ON bit
    U1STASET = _U1STA_URXEN_MASK; 
}

uint8_t UART1_Read(void)
{
    while(!(U1STAbits.URXDA == 1))
    {
    }

    if ((U1STAbits.OERR == 1))
    {
        U1STACLR = _U1STA_OERR_MASK;
    }

    return U1RXREG;
}

void UART1_Write(uint8_t txData)
{
    while(U1STAbits.UTXBF == 1)
    {
    }

    U1TXREG = txData;    // Write the data byte to the USART.
}

bool UART1_IsRxReady(void)
{
    return U1STAbits.URXDA;
}

bool UART1_IsTxReady(void)
{
    return (U1STAbits.TRMT && U1STAbits.UTXEN );
}

bool UART1_IsTxDone(void)
{
    return U1STAbits.TRMT;
}

/* !!! Deprecated API - This function may not be supported in a future release !!! */
UART1_STATUS __attribute__((deprecated)) UART1_StatusGet (void)
{
    return U1STA;
}

/* !!! Deprecated API - This function may not be supported in a future release !!! */
bool __attribute__((deprecated)) UART1_DataReady(void)
{
    return UART1_IsRxReady();
}

/* !!! Deprecated API - This function may not be supported in a future release !!! */
bool __attribute__((deprecated)) UART1_is_tx_ready(void)
{
    return UART1_IsTxReady();
}

/* !!! Deprecated API - This function may not be supported in a future release !!! */
bool __attribute__((deprecated)) UART1_is_rx_ready(void)
{
    return UART1_IsRxReady();
}

/* !!! Deprecated API - This function may not be supported in a future release !!! */
bool __attribute__((deprecated)) UART1_is_tx_done(void)
{
    return UART1_IsTxDone();
}

void _mon_putc(char c) {
    UART1_Write(c);
}
