controlXic/onYX_Wind_Gesture_Midi_Controller/00_FIRMWARE/onyx_uChip_048/onyx_uChip_048.X/byteToSound.h

#include <stdint.h>
#include <stdbool.h>

#ifndef _BYTETOSOUND_H    /* Guard against multiple inclusion */
#define _BYTETOSOUND_H


/* Provide C++ Compatibility */
#ifdef __cplusplus
extern "C" {
#endif

void Octave_0_On(void);
void Octave_0_Off(void);
void octave_0_all_off(void);

void Octave_1_On(void);
void Octave_1_Off(void);

void Octave_2_On(void);
void Octave_2_Off(void);

void Octave_3_On(void);
void Octave_3_Off(void);


#ifdef __cplusplus
}
#endif

#endif /* _EXAMPLE_FILE_NAME_H */
