controlXic/onYX_Wind_Gesture_Midi_Controller/00_FIRMWARE/onyx_uChip_048/onyx_uChip_048.X/samplerMode.h

#ifndef _SAMPLER_MODE_H    /* Guard against multiple inclusion */
#define _SAMPLER_MODE_H


/* Provide C++ Compatibility */
#ifdef __cplusplus
extern "C" {
#endif

void samplerMode();

    /* Provide C++ Compatibility */
#ifdef __cplusplus
}
#endif

#endif /* _EXAMPLE_FILE_NAME_H */

/* *****************************************************************************
 End of File
 */
